EdgeCoil/tune-button/README.md

# Tune Button

A pocket remote for Spotify on Android. Out of the box its four keys **like** the song that's
playing, **add it to a playlist**, **skip**, and **play or pause**. Each key can also do something
else when held or double-pressed. It runs for months on a small battery and charges over USB-C.

It is **not a Bluetooth keyboard**, so nothing on the phone gets remapped. Each press sends a small,
signed Bluetooth broadcast. A companion app hears it in the background, even with the phone locked,
and does what you set that key to do.

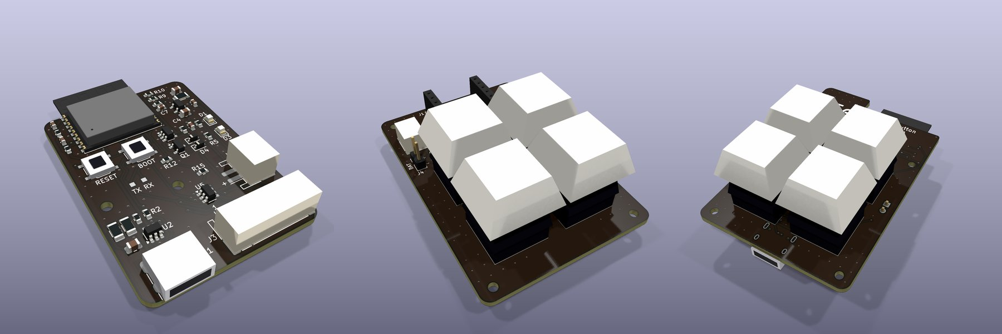
[picture p1: docs/renders/boards.jpg]
The three Tune Button boards

<sub>The three four-key boards (renders of rev A, which has arrived and is being brought up): `c3-jst` with buttons on a cable, the XIAO board, and the C3 board's key side.</sub>

```
 button ──wake──► ESP32-C3 ──signed BLE broadcast──► Android app ──HTTPS──► Spotify
                 (deep sleep)                      (listens in the         like, add, skip,
                                                    background)            play/pause, …
```

> **Status: works end to end.** A one-button unit on a XIAO ESP32-C3 liked the playing song from a
> locked Samsung phone; the app heard the press in 0.8 s. The four-key firmware and app (holds,
> double presses, playback control) are written and unit-tested; on the rev A boards the C3 board's
> four keys, sleep and wake work (2026-11-05), the XIAO board is flashed (without a cell so far), and the app hasn't been
> paired with a four-key board yet. Still to do: a longer latency run on each scan mode and a
> battery-life measurement. See [`docs/design.md`](docs/design.md).

## What you need

- **The button:** one of the four-key boards (see [Hardware](#hardware)), or a hand-wired Seeed
  Studio XIAO ESP32-C3 with a small LiPo cell and one or two 12 mm tactile switches
  ([`hardware/wiring.md`](hardware/wiring.md)). There are 3D-printable cases, and layered acrylic
  cases for the four-key boards ([`hardware/case`](hardware/case/README.md)).
- **An Android phone**, version 8.0 or later.
- **Spotify Premium.** Spotify requires it on the account that owns the developer app, and the
  developer app works for up to five users.

## Set up

### 1. Create a Spotify developer app

1. Sign in at [developer.spotify.com/dashboard](https://developer.spotify.com/dashboard) and create
   an app. Tick **Web API**.
2. Add the redirect URI **`tunebutton://callback`**.
3. Copy the **Client ID**. You don't need a client secret: the app signs in with PKCE.

### 2. Flash the firmware

Pick the build for your button:

| Button | Build (`-e`) | `sh scripts/merge.sh <build>` makes |
|---|---|---|
| Hand-wired XIAO, two buttons | `xiao_esp32c3` (the default) | `tune-button-c3.bin` |
| Hand-wired XIAO, one button | `xiao_esp32c3_1btn` | `tune-button-c3-1btn.bin` |
| XIAO four-key board | `xiao_board` | `tune-button-xiao-board.bin` |
| `c3` or `c3-jst` board | `c3_board` | `tune-button-c3-board.bin` |

With PlatformIO:

```bash
cd firmware
pio test -e native            # host tests: packet encoder, signatures and key gestures
pio run -e c3_board -t upload # build and flash over USB-C
```

Or make one image (table above) and flash it at offset `0x0`, either in Chrome with
[esptool-js](https://espressif.github.io/esptool-js/) or with
`esptool.py --chip esp32c3 write_flash 0 tune-button-c3.bin`.

**Only have one button?** Wire it to D1. A press acts when you let go; holding it for 5 seconds pairs.

Things worth knowing:
- **On a computer's USB it stays awake**, so the serial port stays up: `pio device monitor` shows a
  line per wake and per key sent, and `pio run -t upload` works as is. It notices within a few ms
  when the computer goes away, and sleeps. A plain USB charger sends no USB frames, so on one it
  sleeps as usual. Build with `-DTB_USB_HEARTBEAT` to also print the raw key state once a second.
- **Otherwise the USB port vanishes while the button sleeps**, which is almost all the time. To
  flash it, plug it into a computer and press a key (it stays up once the press is sent), or hold
  **BOOT** while plugging it in.
- **If it sits in `waiting for download` after an upload**, the reset after flashing kept it in
  the bootloader: unplug and replug it. `--after watchdog_reset` (esptool) avoids this.
- **Flashing the merged image at `0x0` erases the pairing**, so pair again afterwards.
  `pio run -t upload` keeps it.
- Build options in `platformio.ini`: `TB_BURST_MS` (how long each press is broadcast) and `TB_LED_PIN`.
- **Updating from the two-button firmware** keeps the pairing (with `pio run -t upload`), and the
  app still understands a button that hasn't been updated.

### 3. Install the app

```bash
cd android
./gradlew test assembleDebug      # needs JDK 17+ and Android SDK 35
```

Install `app/build/outputs/apk/debug/app-debug.apk` on the phone, open it and work down the screen:

1. Paste the Client ID and tap **Sign in to Spotify**. (Signed in before playback control existed?
   The app asks you to sign in again, to allow it.)
2. **Pair:** hold keys 1 and 2 (top left and top right) for 3 seconds (one-button build: hold it for
   5 seconds) until the LED flickers, then tap **Pair**. Accept the Bluetooth prompt if one appears.
   Pairing makes a fresh key, so a previously paired phone stops working; a pairing that no phone
   completes changes nothing.
3. **Keys:** tap any key's press, hold or double press to choose what it does. Key 2's press needs
   a playlist.
4. Fix everything listed under *Keep listening in the background*. **On Samsung phones, also add the
   app to *Never sleeping apps*,** or presses stop being heard after a few days.
5. Tap **Test without the device** to check the Spotify side on its own.

## Using it

Press a key. Within a moment the phone buzzes once and shows a notification, for example
"♥ Liked — Title · Artist" or "⏭ Next track". If something goes wrong it buzzes twice and says why:
nothing playing, signed out, a local file, and so on. Podcast episodes work too.

What a key can do, on press, hold (0.6 s) or double press:

| | |
|---|---|
| **The song** | like it, remove it from Liked Songs, add it to a playlist, remove it from a playlist |
| **Playback** | play / pause, next, previous, volume up or down 10 %, shuffle on / off, repeat (off → all → one), play a playlist |
| **Anything else** | call a webhook, such as a Home Assistant automation. It gets the key, the gesture and the song |

Each slot has its own playlist, so key 2 could add to one playlist and key 2 held to another.

**Holds and double presses cost a little speed, on that key only.** A key with nothing on hold or
double press sends the moment it goes down. One with a hold action waits for you to let go (or for
the hold); one with a double press waits 0.3 s for a second press. The button has to know which keys
wait, so after changing those, the app asks you to hold keys 1 and 2 for 3 seconds and tap **Send
key settings**. That doesn't re-pair anything.

Quick presses all count: three fast presses of skip are three skips.

The app's *Recent presses* list shows, for each press, how long the phone took to hear it, how long
Spotify took, the button's battery level and the result.

## Hardware

| Option | What it is | State |
|---|---|---|
| **Hand-wired XIAO** | A XIAO ESP32-C3 with one or two switches and a LiPo: [`hardware/wiring.md`](hardware/wiring.md) | One-button unit built and working |
| **3D-printed case** | Parametric OpenSCAD, with ready STLs: [`hardware/case/`](hardware/case/) | Ready to print |
| **Four-key PCBs** | Three boards: one carrying a XIAO, one with the ESP32-C3 module on board, and a small one that takes buttons on a cable. [`hardware/pcb/`](hardware/pcb/) | Rev A in bring-up; XIAO rev B designed |

The firmware supports all four boards. It runs on the rev A C3 board and is flashed on the rev A XIAO board (without a cell so far); `c3-jst` is untested.

## How it's put together

| Path | What it is |
|---|---|
| [`firmware/`](firmware/) | PlatformIO / Arduino firmware for the ESP32-C3 (NimBLE) |
| [`android/`](android/) | The companion app (Kotlin, Android 8+) |
| [`protocol/`](protocol/) | The broadcast format, and `gen_vectors.py`, which makes the test vectors both sides check against |
| [`hardware/`](hardware/) | Wiring, parts, the case and the PCBs |
| [`docs/design.md`](docs/design.md) | How it works, security, power budget, latency and bench tests |

Each press is signed with a key shared at pairing and carries a counter, so the app ignores copies
and anything not from your button. [`docs/design.md`](docs/design.md) has the details.

## Licence

| What | Licence |
|---|---|
| The case and PCBs: `hardware/case/`, `hardware/pcb/` (OpenSCAD and KiCad sources, STLs) | [CERN-OHL-S-2.0](LICENSES/CERN-OHL-S-2.0.txt) |
| Firmware, app, protocol tools | [MIT](LICENSES/MIT.txt) |
| The Gradle wrapper (`android/gradlew*`, `android/gradle/wrapper/`), as shipped by Gradle | [Apache-2.0](LICENSES/Apache-2.0.txt) |
| Documentation (`README.md`, `docs/` including the renders, `hardware/wiring.md`, `protocol/spec.md`) | [CC BY 4.0](LICENSES/CC-BY-4.0.txt) |
| The EdgeCoil mark (`hardware/pcb/edgecoil-mark.svg` and the silkscreen drawn from it), name and URL | [All rights reserved](LICENSES/LicenseRef-EdgeCoil-Mark.txt) |

Each source file carries an SPDX header, and [`REUSE.toml`](REUSE.toml) covers the rest by path.

The board licence does not cover the EdgeCoil mark, name or URL on the silkscreen. If you make or
sell boards from these designs, take them off.

Spotify is a trademark of Spotify AB. This project is not affiliated with or endorsed by Spotify.

---

edgecoil · [edgecoil.dev](https://edgecoil.dev)
