EdgeCoil/tune-button/hardware/case/stack/c3-jst/preview.png

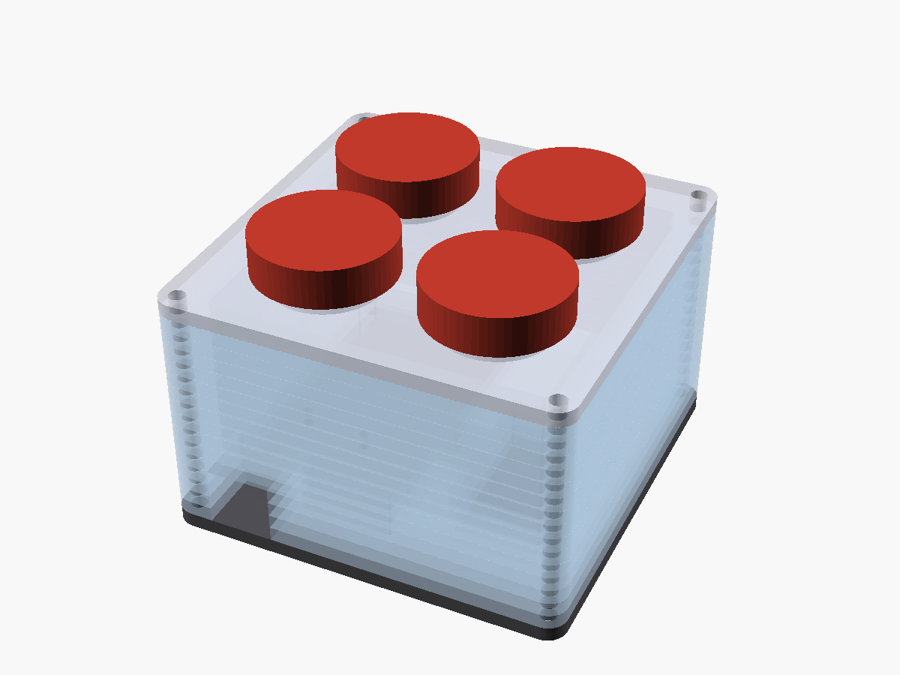
hardware/case/stack/c3-jst/preview.png
