EdgeCoil/tune-button/hardware/case/stack/c3-jst/wall.stl

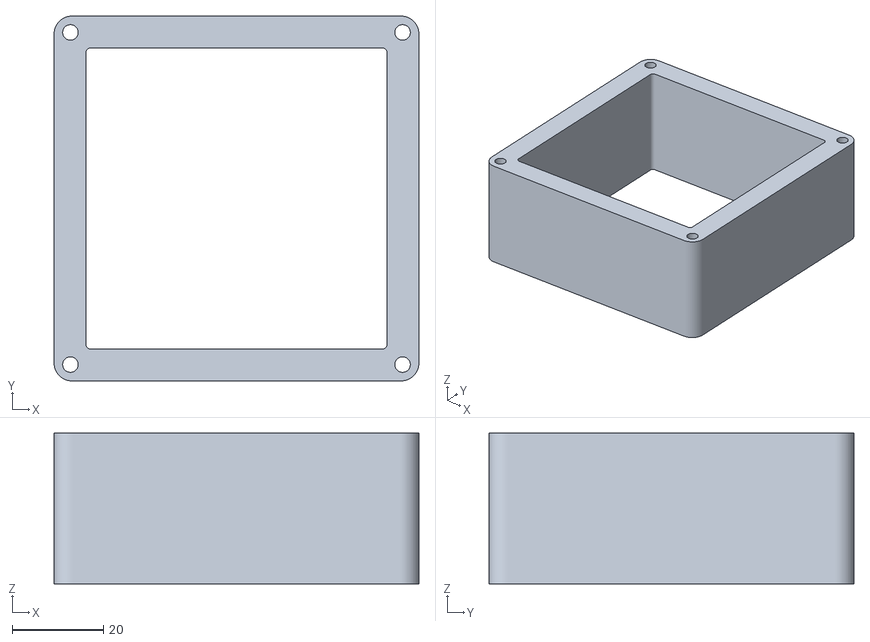
[picture p10: CAD file, 2026-11-04]
hardware/case/stack/c3-jst/wall.stl
80.0 x 80.0 x 33.0
