EdgeCoil/tune-button/hardware/case/stack/c3/sheet.dxf

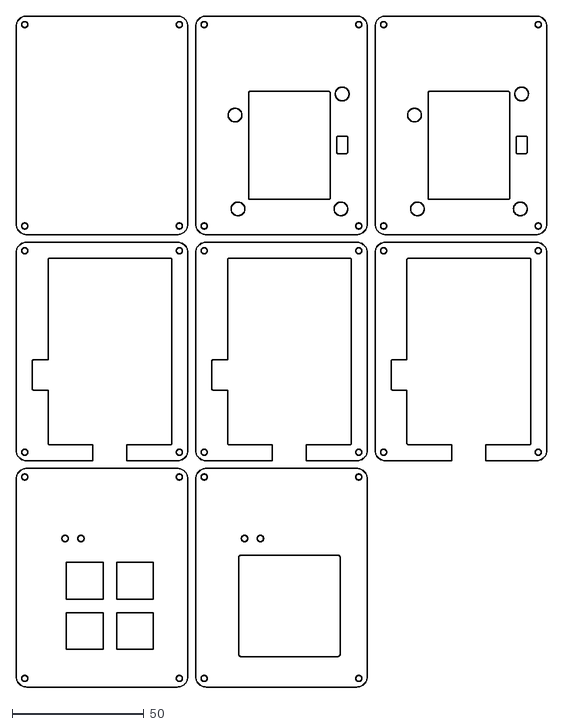
[picture p11: CAD file, 2026-11-04]
hardware/case/stack/c3/sheet.dxf
201.1 x 254.3
