EdgeCoil/tune-button/hardware/case/stack/xiao/spacers.stl

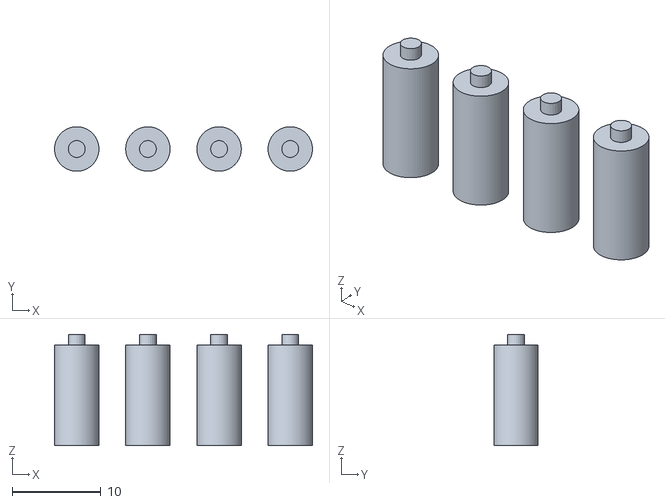
[picture p12: CAD file, 2026-11-04]
hardware/case/stack/xiao/spacers.stl
29.0 x 5.00 x 12.5
