EdgeCoil/tune-button/hardware/case/tune-button-c3-raven-tower.stl

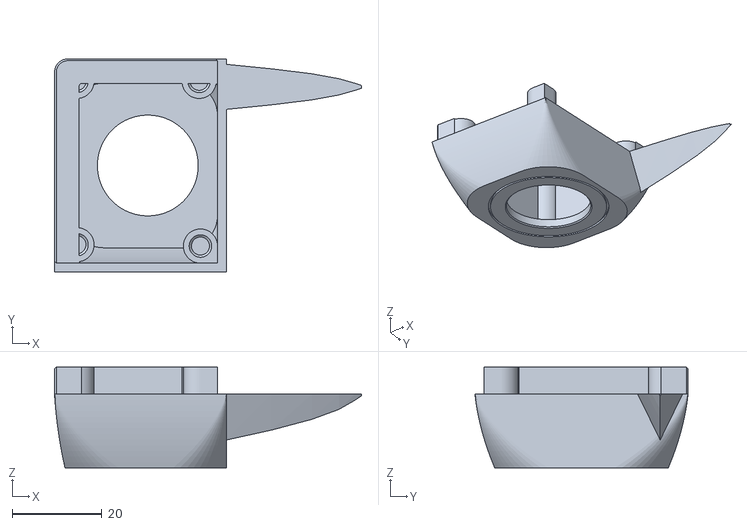
[picture p13: CAD file, 2026-11-13]
hardware/case/tune-button-c3-raven-tower.stl
68.3 x 47.4 x 22.4
