EdgeCoil/tune-button/hardware/case/stack/c3-jst/sheet.dxf

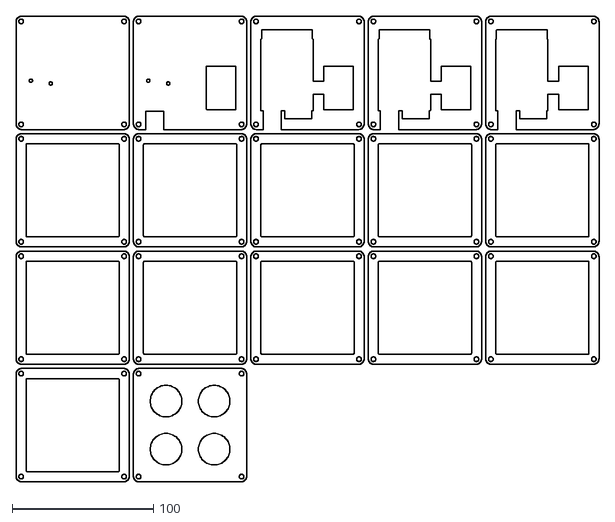
[picture p14: CAD file, 2026-11-04]
hardware/case/stack/c3-jst/sheet.dxf
412.1 x 329.1
