EdgeCoil/tune-button/hardware/case/stack/xiao/sheet.dxf

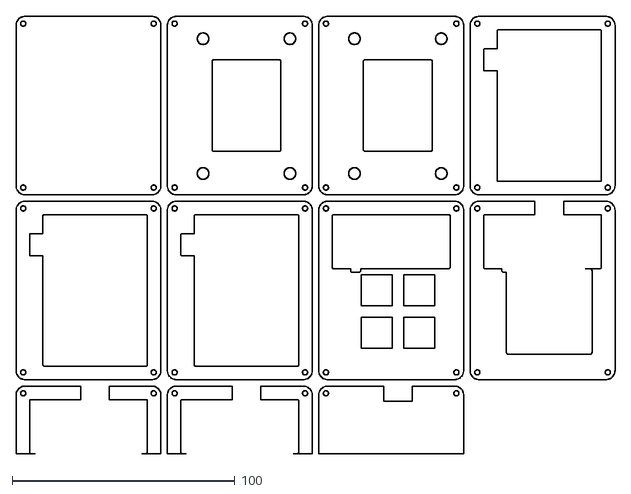
[picture p15: CAD file, 2026-11-04]
hardware/case/stack/xiao/sheet.dxf
269.1 x 196.5
