EdgeCoil/tune-button/hardware/case/tune-button-c3-raven-base.stl

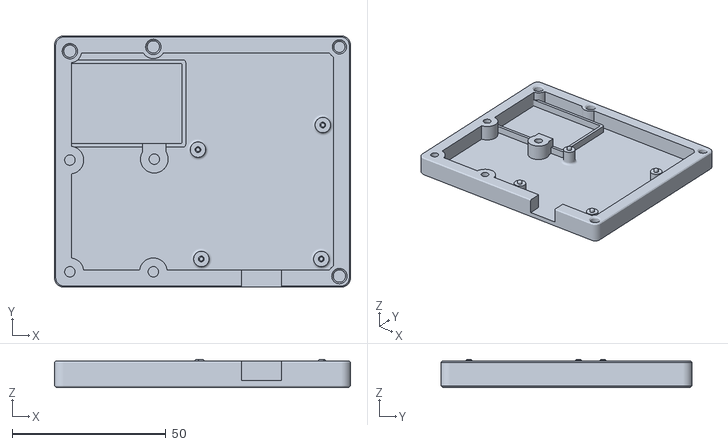
[picture p16: CAD file, 2026-11-13]
hardware/case/tune-button-c3-raven-base.stl
96.2 x 81.7 x 9.20
