EdgeCoil/tune-button/hardware/case/tune-button-c3-btn-tower.stl

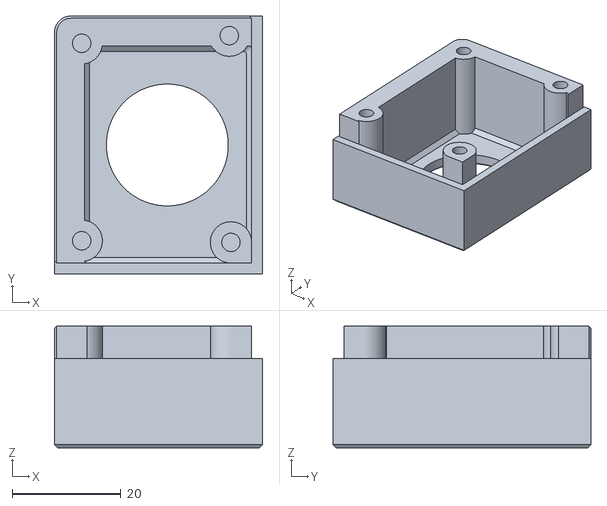
[picture p17: CAD file, 2026-11-09]
hardware/case/tune-button-c3-btn-tower.stl
38.2 x 47.4 x 22.4
