EdgeCoil/tune-button/hardware/case/tune-button-c3-btn-lid.stl

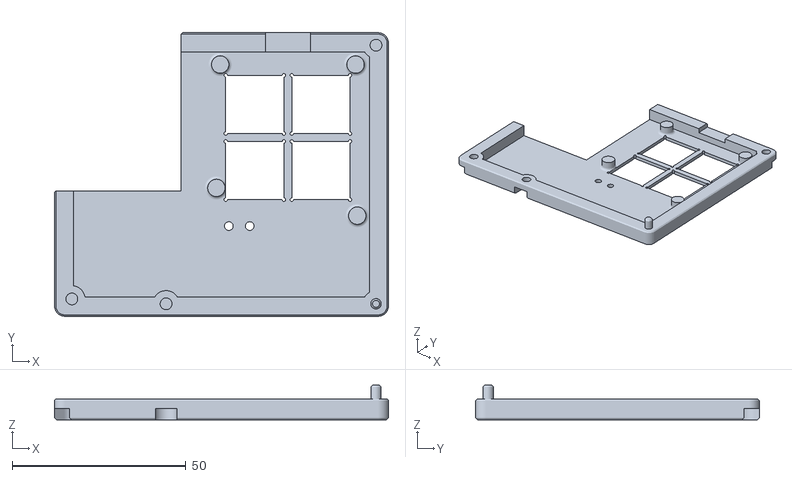
[picture p18: CAD file, 2026-11-09]
hardware/case/tune-button-c3-btn-lid.stl
96.2 x 81.7 x 10.00
