EdgeCoil/tune-button/hardware/case/tune-button-c3-lid.stl

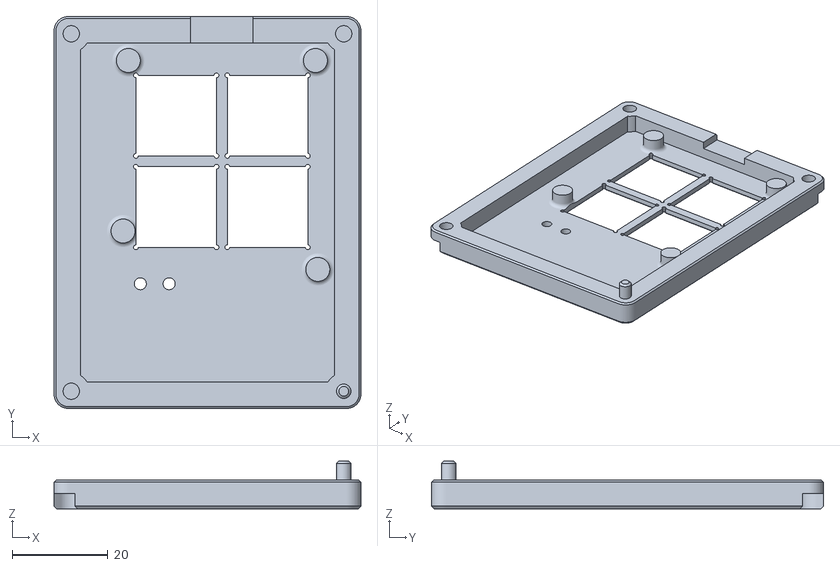
[picture p19: CAD file, 2026-11-05]
hardware/case/tune-button-c3-lid.stl
64.0 x 81.7 x 10.00
