EdgeCoil/tune-button/hardware/case/tune-button-xiao-lid.stl

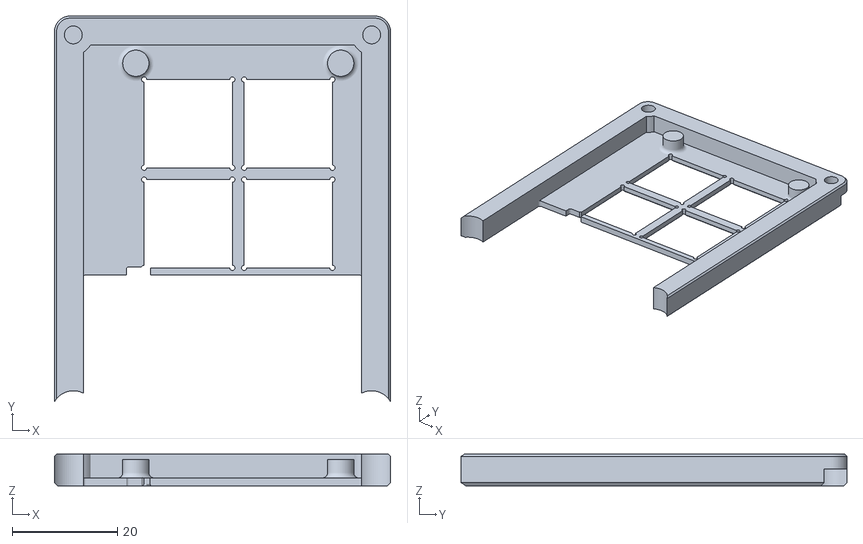
[picture p20: CAD file, 2026-11-05]
hardware/case/tune-button-xiao-lid.stl
64.0 x 73.5 x 6.00
