EdgeCoil/tune-button/hardware/case/tune-button-mx-gauge.stl

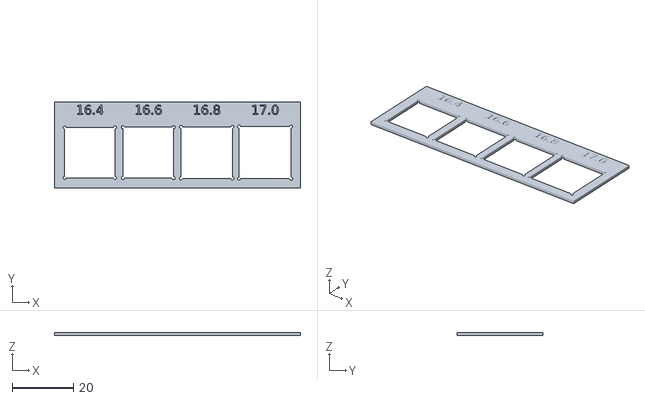
[picture p21: CAD file, 2026-11-05]
hardware/case/tune-button-mx-gauge.stl
80.2 x 28.1 x 1.00
