EdgeCoil/tune-button/hardware/case/tune-button-xiao-hood.stl

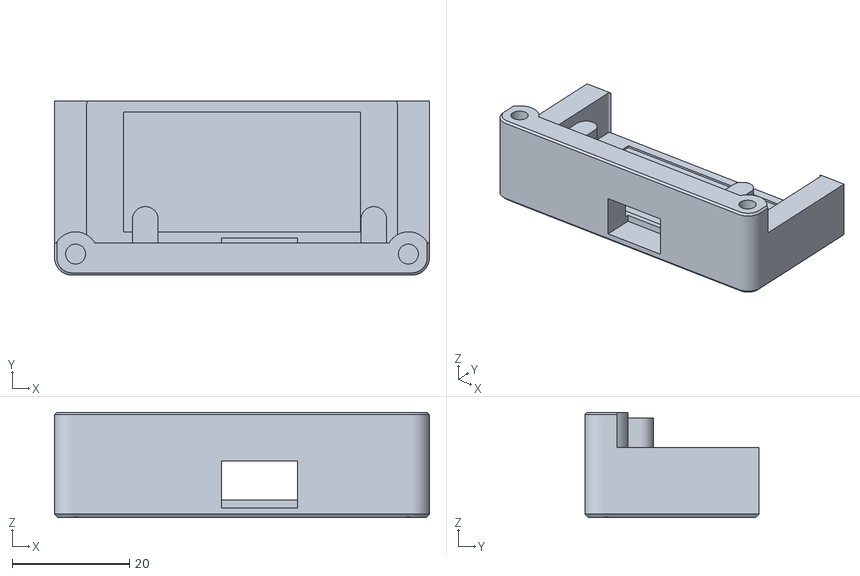
[picture p22: CAD file, 2026-11-04]
hardware/case/tune-button-xiao-hood.stl
64.0 x 29.8 x 18.0
