EdgeCoil/tune-button/hardware/case/tune-button-xiao-base.stl

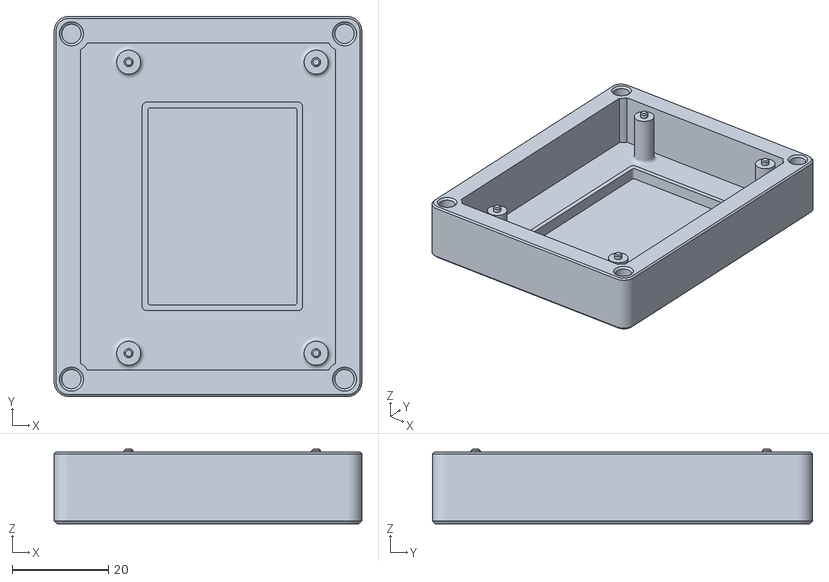
[picture p23: CAD file, 2026-11-04]
hardware/case/tune-button-xiao-base.stl
64.0 x 79.0 x 15.6
