EdgeCoil/tune-button/hardware/case/tune-button-c3-base.stl

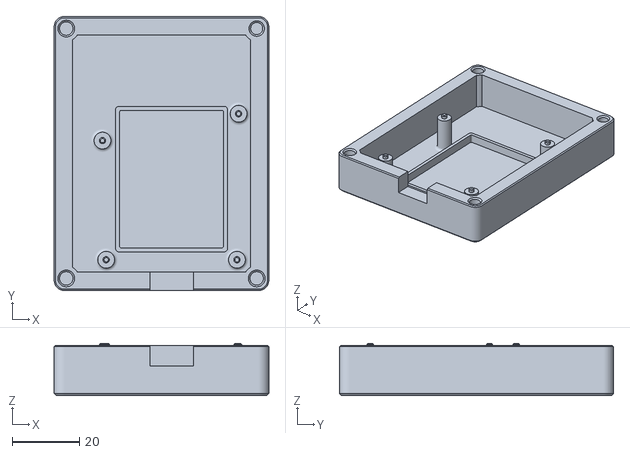
[picture p24: CAD file, 2026-11-04]
hardware/case/tune-button-c3-base.stl
64.0 x 81.7 x 15.6
