EdgeCoil/tune-button/hardware/case/tune-button-1btn-base.stl

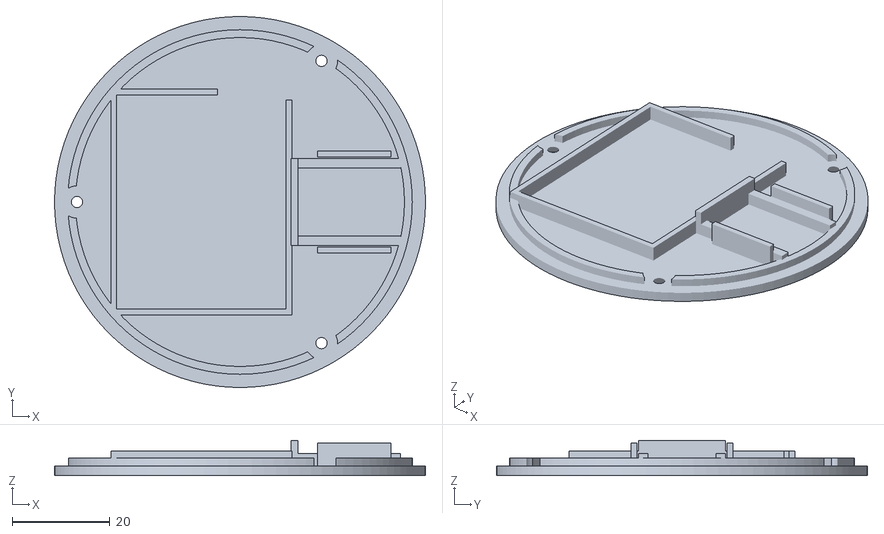
[picture p25: CAD file, 2026-10-21]
hardware/case/tune-button-1btn-base.stl
75.8 x 75.8 x 7.20
