EdgeCoil/tune-button/hardware/case/tune-button-1btn-body.stl

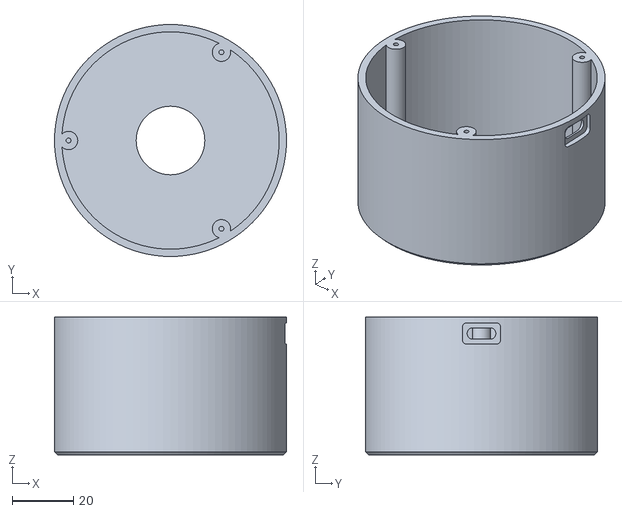
[picture p26: CAD file, 2026-10-21]
hardware/case/tune-button-1btn-body.stl
75.8 x 75.8 x 45.0
