EdgeCoil/tune-button/hardware/case/tune-button-lid.stl

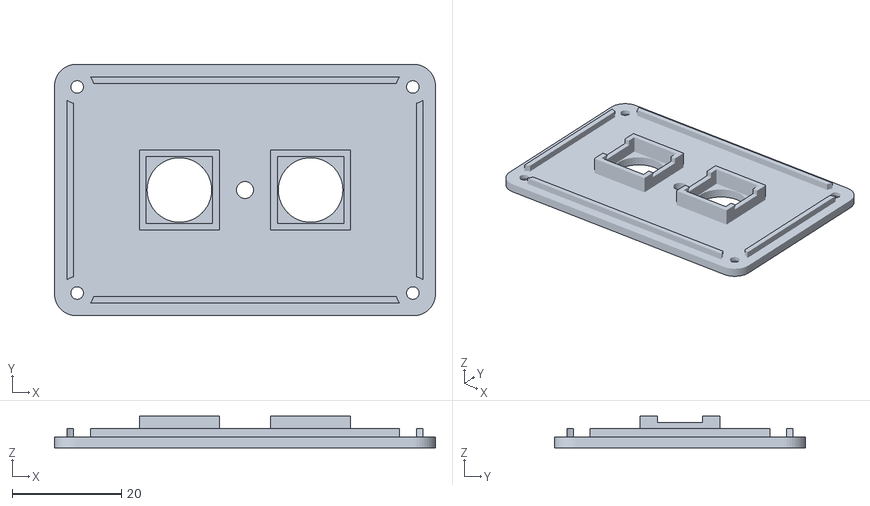
[picture p27: CAD file, 2026-10-19]
hardware/case/tune-button-lid.stl
69.7 x 46.0 x 5.80
