EdgeCoil/tune-button/hardware/case/tune-button-base.stl

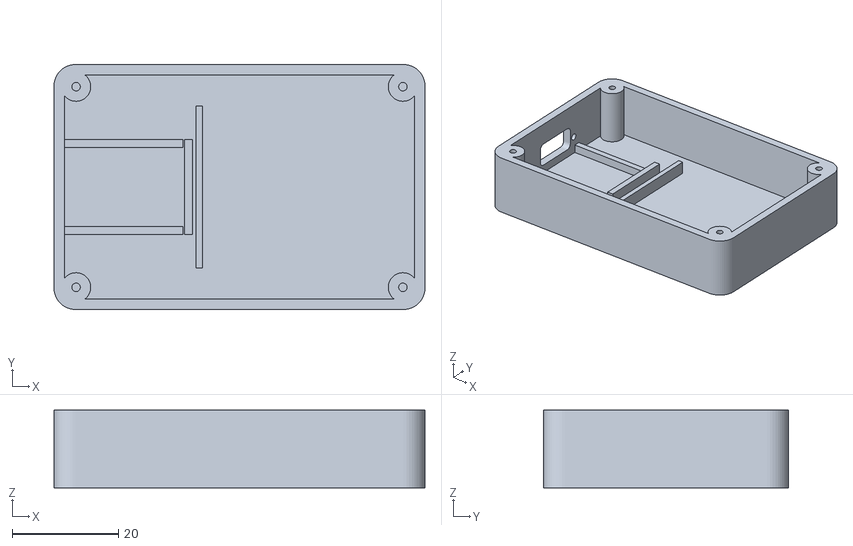
[picture p28: CAD file, 2026-10-19]
hardware/case/tune-button-base.stl
69.7 x 46.0 x 14.6
