EdgeCoil/tune-button/hardware/case/tune-button-mx-gauge.scad

// SPDX-FileCopyrightText: 2026 edgecoil
// SPDX-License-Identifier: CERN-OHL-S-2.0
//
// MX hole gauge: four switch holes cut the same way as the printed lid's plate (1.5 mm, corner
// reliefs, the chamfer on the bed face). Print it with the same filament and settings as the lid.
//   mx_fit "over" (the default): push a soldered switch's top up through each hole from below and
//     pick the smallest it passes cleanly, flange and all.
//   mx_fit "clip": press a switch in from above and pick the smallest it goes fully into, clips
//     latched. Build with -D 'mx_fit="clip"'.
// Then set pmx_hole in tune-button-printed.scad.
//
//   openscad -o tune-button-mx-gauge.stl tune-button-mx-gauge.scad
include <tune-button-printed.scad>
piece = "none";

sizes = mx_fit == "over" ? [16.4, 16.6, 16.8, 17.0] : [14.0, 14.1, 14.2, 14.3];
labels = [for (x = sizes) let(s = str(x)) len(s) == 2 ? str(s, ".0") : s];
pitch = 19.05;
t = plate_t;
w = len(sizes) * pitch + 4;
d = pitch + 9;
assert(sizes[len(sizes) - 1] + 1 < pitch, "holes too big for the pitch");

// Built upright (top face at z = t), then turned over: the top face prints on the bed, as on the lid.
translate([0, 0, t]) rotate([180, 0, 0]) difference() {
    translate([-w / 2, -d / 2, 0]) cube([w, d, t]);
    for (i = [0 : len(sizes) - 1]) translate([(i - (len(sizes) - 1) / 2) * pitch, 2.5, 0]) mx_cut(t, sizes[i]);
    // each size engraved under its hole, on the underside (the side facing up as printed)
    for (i = [0 : len(sizes) - 1]) translate([(i - (len(sizes) - 1) / 2) * pitch, -d / 2 + 2.6, -0.01])
        mirror([0, 1, 0]) linear_extrude(height = 0.6) text(labels[i], size = 3, halign = "center", valign = "center");
}
