EdgeCoil/tune-button/(list of files, cad)

Other CAD files:
hardware/case/stack/c3/spacers.stl
hardware/case/tune-button-c3-btn-base.stl
