EdgeCoil/tune-button/hardware/case/stack/c3/printed-preview.png

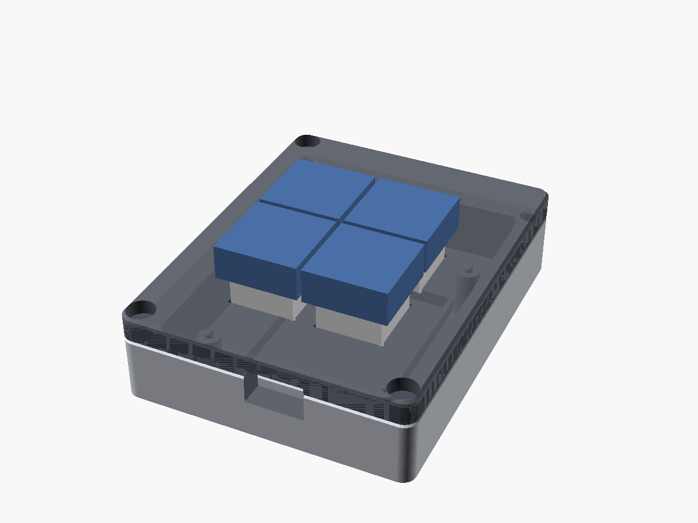
hardware/case/stack/c3/printed-preview.png
