EdgeCoil/tune-button/hardware/pcb/xiao/tune-button-xiao.kicad_pcb

## KiCad design hardware/pcb/xiao/tune-button-xiao.kicad_pcb (2026-11-05)

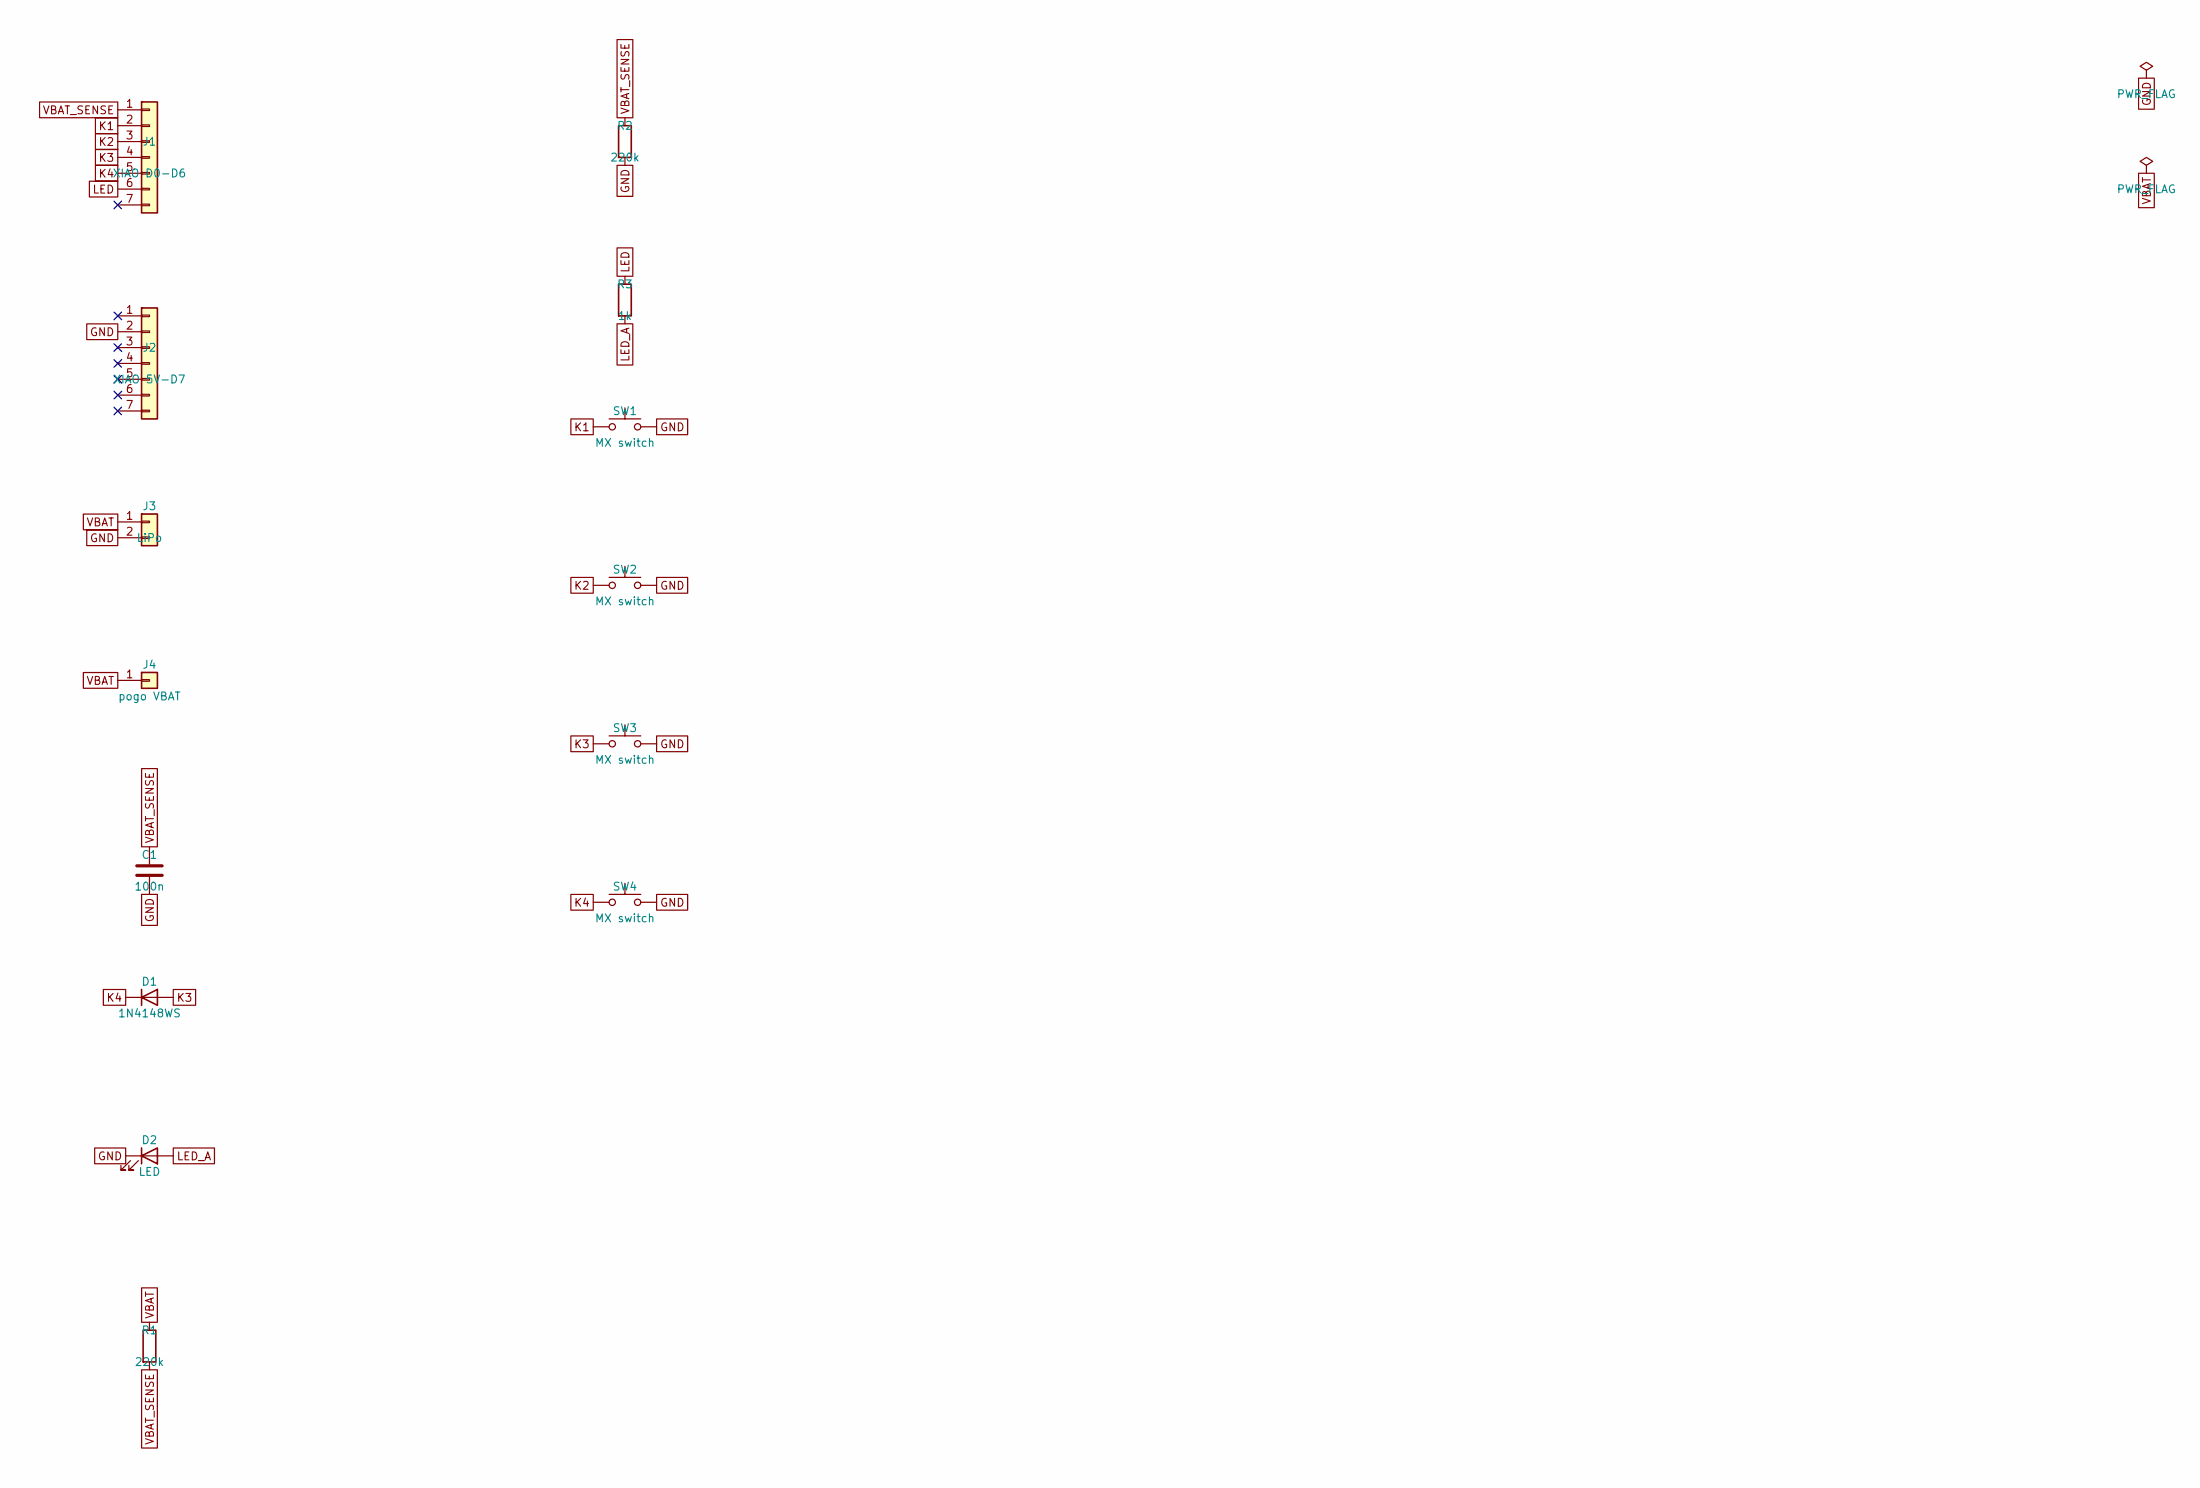
[picture p30: schematic tune-button-xiao.kicad_sch, tune-button xiao]

Parts:
C1: 100n; C_0603_1608Metric; LCSC C14663
D1: 1N4148WS; D_SOD-323_HandSoldering; MPN 1N4148WS; LCSC C2128
D2: LED; LED_0603_1608Metric; LCSC C2286
J1: XIAO D0-D6; PinSocket_1x07_P2.54mm_Vertical; MPN Kinghelm KH-2.54FH-1X7P-H8.5; LCSC C2932672
J2: XIAO 5V-D7; PinSocket_1x07_P2.54mm_Vertical; MPN Kinghelm KH-2.54FH-1X7P-H8.5; LCSC C2932672
J3: LiPo; JST_PH_S2B-PH-SM4-TB_1x02-1MP_P2.00mm_Horizontal; MPN JST S2B-PH-SM4-TB; LCSC C295747
J4: pogo VBAT; PogoPin_YTC1P_D2.0_SMD; MPN YIYUAN YTC1P-8535-01; LCSC C5221289
R1, R2: 220k; R_0603_1608Metric; LCSC C22961
R3: 1k; R_0603_1608Metric; LCSC C21190
SW1, SW2, SW3, SW4: MX switch; SW_Cherry_MX_1.00u_PCB_Reversible; MPN Cherry MX (3 or 5 pin)

Connections:
GND: C1.2, D2.1 (K), J2.2, J3.2, R2.2, SW1.2, SW2.2, SW3.2, SW4.2
K1: J1.2, SW1.1
K2: J1.3, SW2.1
K3: D1.2 (A), J1.4, SW3.1
K4: D1.1 (K), J1.5, SW4.1
LED: J1.6, R3.1
LED_A: D2.2 (A), R3.2
VBAT: J3.1, J4.1, R1.1
VBAT_SENSE: C1.1, J1.1, R1.2, R2.1

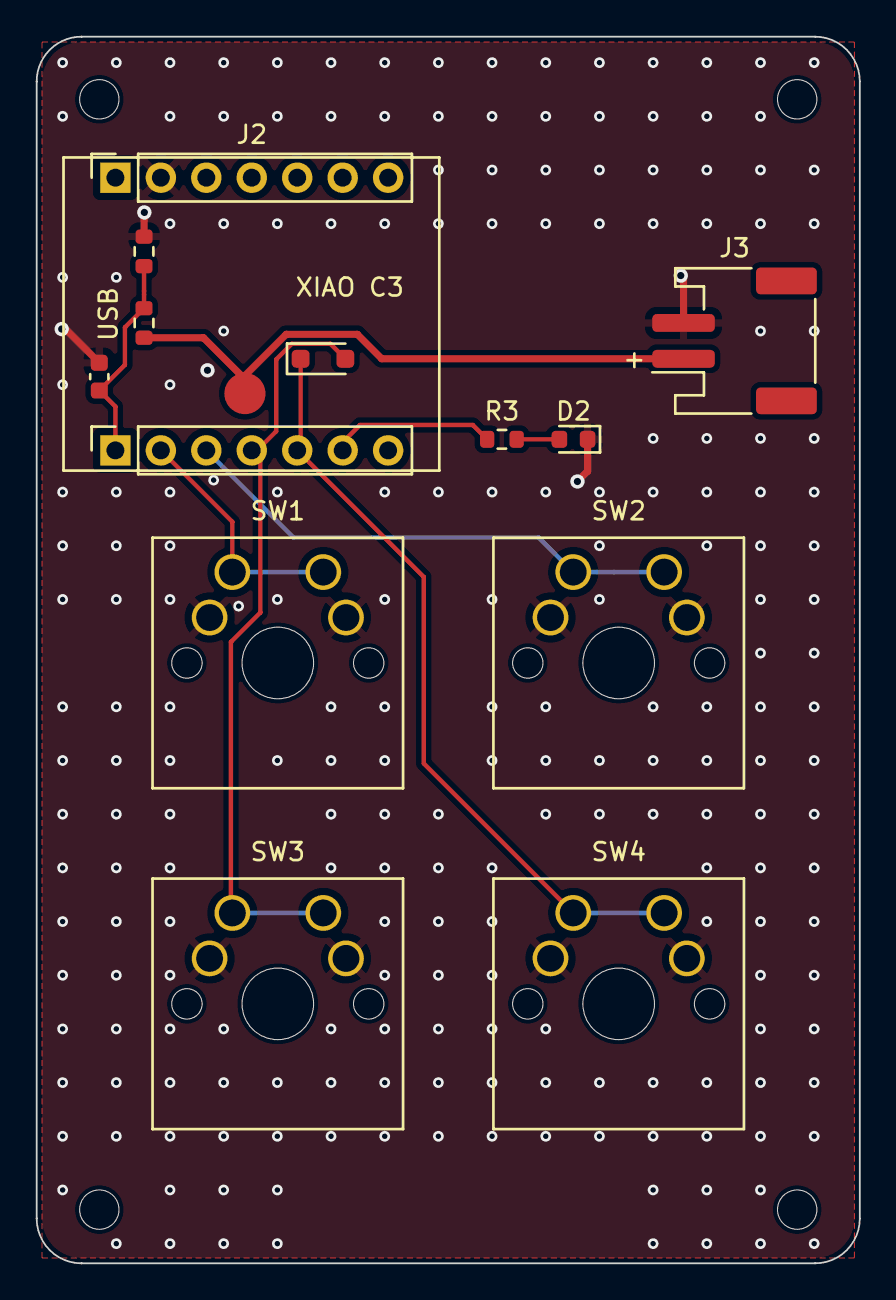
[picture p31: board tune-button-xiao.kicad_pcb from above]

Board: 2 copper layers, 46.0 x 68.5 mm, 18 parts (0 on the bottom side), 9 nets.

Other parts of the board:
H1, H2, H3, H4: M2; MountingHole_2.2mm_M2
