EdgeCoil/tune-button/hardware/pcb/c3/tune-button-c3.kicad_pcb

## KiCad design hardware/pcb/c3/tune-button-c3.kicad_pcb (2026-10-25)

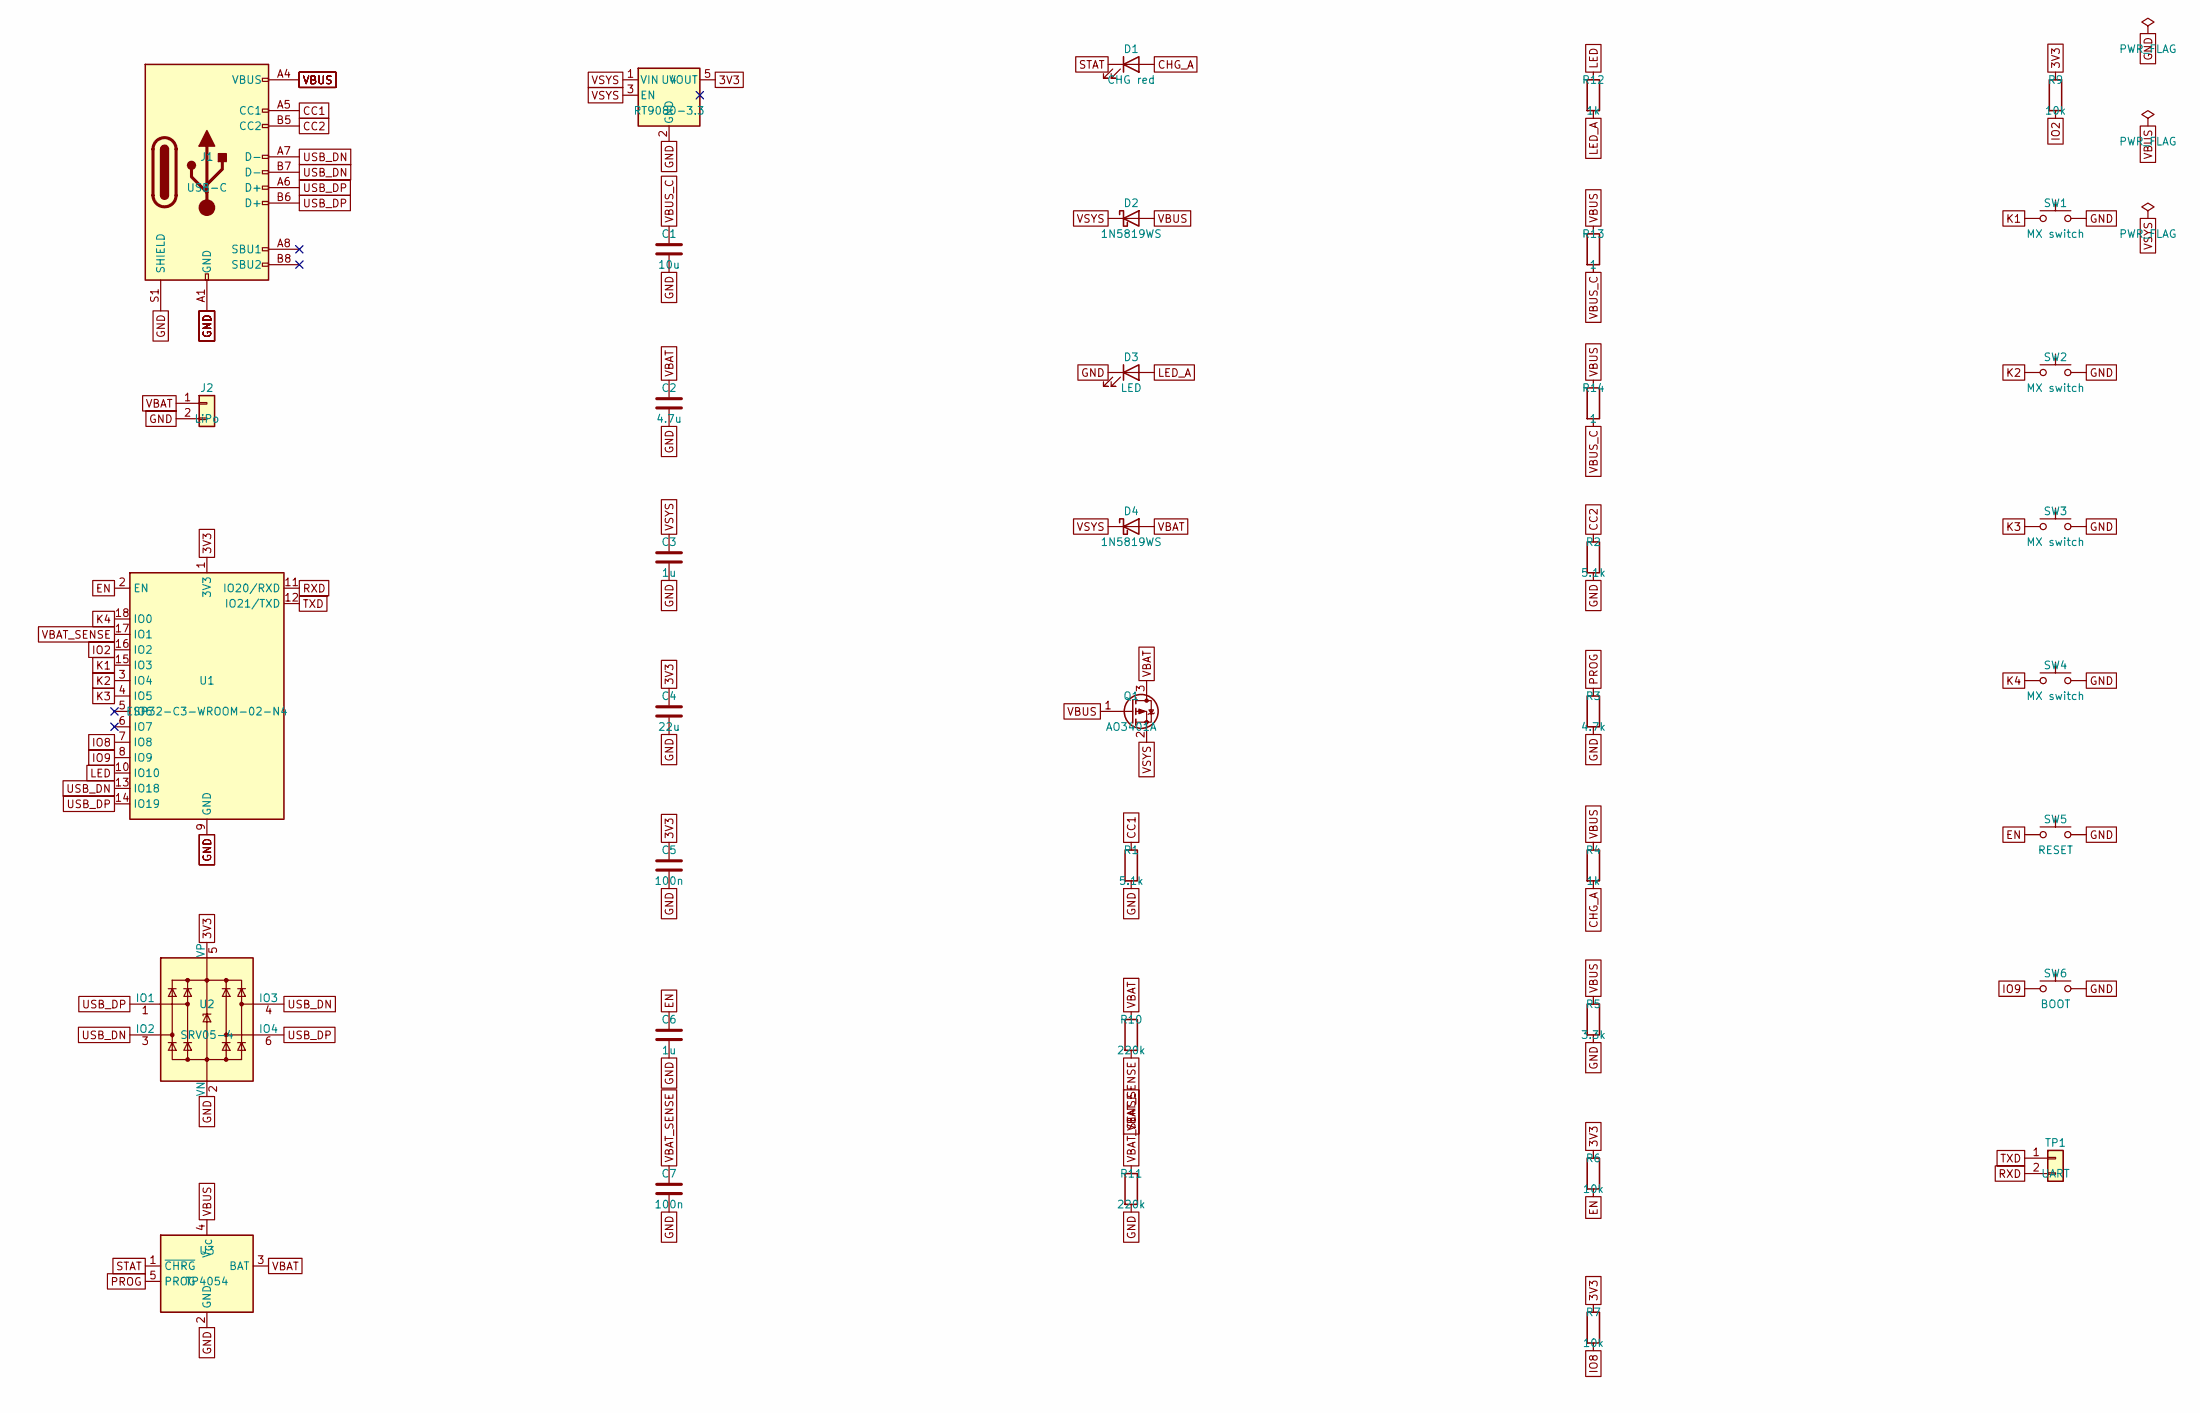
[picture p32: schematic tune-button-c3.kicad_sch, tune-button c3]

Parts:
C1: 10u; C_0805_2012Metric; LCSC C15850
C2: 4.7u; C_0603_1608Metric; LCSC C19666
C3, C6: 1u; C_0603_1608Metric; LCSC C15849
C4: 22u; C_0805_2012Metric; LCSC C45783
C5, C7: 100n; C_0603_1608Metric; LCSC C14663
D1: CHG red; LED_0805_2012Metric
D2, D4: 1N5819WS; D_SOD-323; MPN 1N5819WS; LCSC C191023
D3: LED; LED_0805_2012Metric
J1: USB-C; USB_C_Receptacle_HRO_TYPE-C-31-M-12; MPN HRO TYPE-C-31-M-12; LCSC C165948
J2: LiPo; JST_PH_S2B-PH-SM4-TB_1x02-1MP_P2.00mm_Horizontal; MPN JST S2B-PH-SM4-TB; LCSC C295747
Q1: AO3401A; SOT-23; MPN AO3401A; LCSC C15127
R1, R2: 5.1k; R_0603_1608Metric; LCSC C23186
R3: 4.7k; R_0603_1608Metric; LCSC C23162
R4, R12: 1k; R_0603_1608Metric; LCSC C21190
R5: 3.3k; R_0603_1608Metric; LCSC C22978
R6, R7, R9: 10k; R_0603_1608Metric; LCSC C25804
R10, R11: 220k; R_0603_1608Metric; LCSC C22961
R13, R14: 1; R_1206_3216Metric; LCSC C17928
SW1, SW2, SW3, SW4: MX switch; SW_Cherry_MX_1.00u_PCB; MPN Cherry MX (3 or 5 pin)
SW5: RESET; SW_Push_1P1T_XKB_TS-1187A; MPN XKB TS-1187A-B-A-B; LCSC C318884
SW6: BOOT; SW_Push_1P1T_XKB_TS-1187A; MPN XKB TS-1187A-B-A-B; LCSC C318884
TP1: UART; PinHeader_1x02_P2.54mm_Vertical
U1: ESP32-C3-WROOM-02-N4; ESP32-C3-WROOM-02; MPN ESP32-C3-WROOM-02-N4; LCSC C2934560
U2: SRV05-4; SOT-23-6; MPN SRV05-4-P-T7; LCSC C85364
U3: TP4054; SOT-23-5; MPN TP4054-42-SOT25R; LCSC C32574
U4: RT9080-3.3; SOT-23-5; MPN RT9080-33GJ5; LCSC C841192

Connections:
3V3: C4.1, C5.1, R6.1, R7.1, R9.1, U1.1 (3V3), U2.5 (VP), U4.5 (VOUT)
CC1: J1.A5 (CC1), R1.1
CC2: J1.B5 (CC2), R2.1
CHG_A: D1.2 (A), R4.2
EN: C6.1, R6.2, SW5.1, U1.2 (EN)
GND: C1.2, C2.2, C3.2, C4.2, C5.2, C6.2, C7.2, D3.1 (K), J1.A1 (GND), J1.A12 (GND), J1.B1 (GND), J1.B12 (GND), J1.S1 (SHIELD), J2.2, R1.2, R2.2, R3.2, R5.2, R11.2, SW1.2, SW2.2, SW3.2, SW4.2, SW5.2, SW6.2, U1.9 (GND), U1.19 (GND), U2.2 (VN), U3.2 (GND), U4.2 (GND)
IO2: R9.2, U1.16 (IO2)
IO8: R7.2, U1.7 (IO8)
IO9: SW6.1, U1.8 (IO9)
K1: SW1.1, U1.15 (IO3)
K2: SW2.1, U1.3 (IO4)
K3: SW3.1, U1.4 (IO5)
K4: SW4.1, U1.18 (IO0)
LED: R12.1, U1.10 (IO10)
LED_A: D3.2 (A), R12.2
PROG: R3.1, U3.5 (PROG)
RXD: TP1.2, U1.11 (IO20/RXD)
STAT: D1.1 (K), U3.1 (~CHRG)
TXD: TP1.1, U1.12 (IO21/TXD)
USB_DN: J1.A7 (D-), J1.B7 (D-), U1.13 (IO18), U2.3 (IO2), U2.4 (IO3)
USB_DP: J1.A6 (D+), J1.B6 (D+), U1.14 (IO19), U2.1 (IO1), U2.6 (IO4)
VBAT: C2.1, D4.2 (A), J2.1, Q1.3 (D), R10.1, U3.3 (BAT)
VBAT_SENSE: C7.1, R10.2, R11.1, U1.17 (IO1)
VBUS: D2.2 (A), J1.A4 (VBUS), J1.A9 (VBUS), J1.B4 (VBUS), J1.B9 (VBUS), Q1.1 (G), R4.1, R5.1, R13.1, R14.1, U3.4 (V_{CC})
VBUS_C: C1.1, R13.2, R14.2
VSYS: C3.1, D2.1 (K), D4.1 (K), Q1.2 (S), U4.1 (VIN), U4.3 (EN)

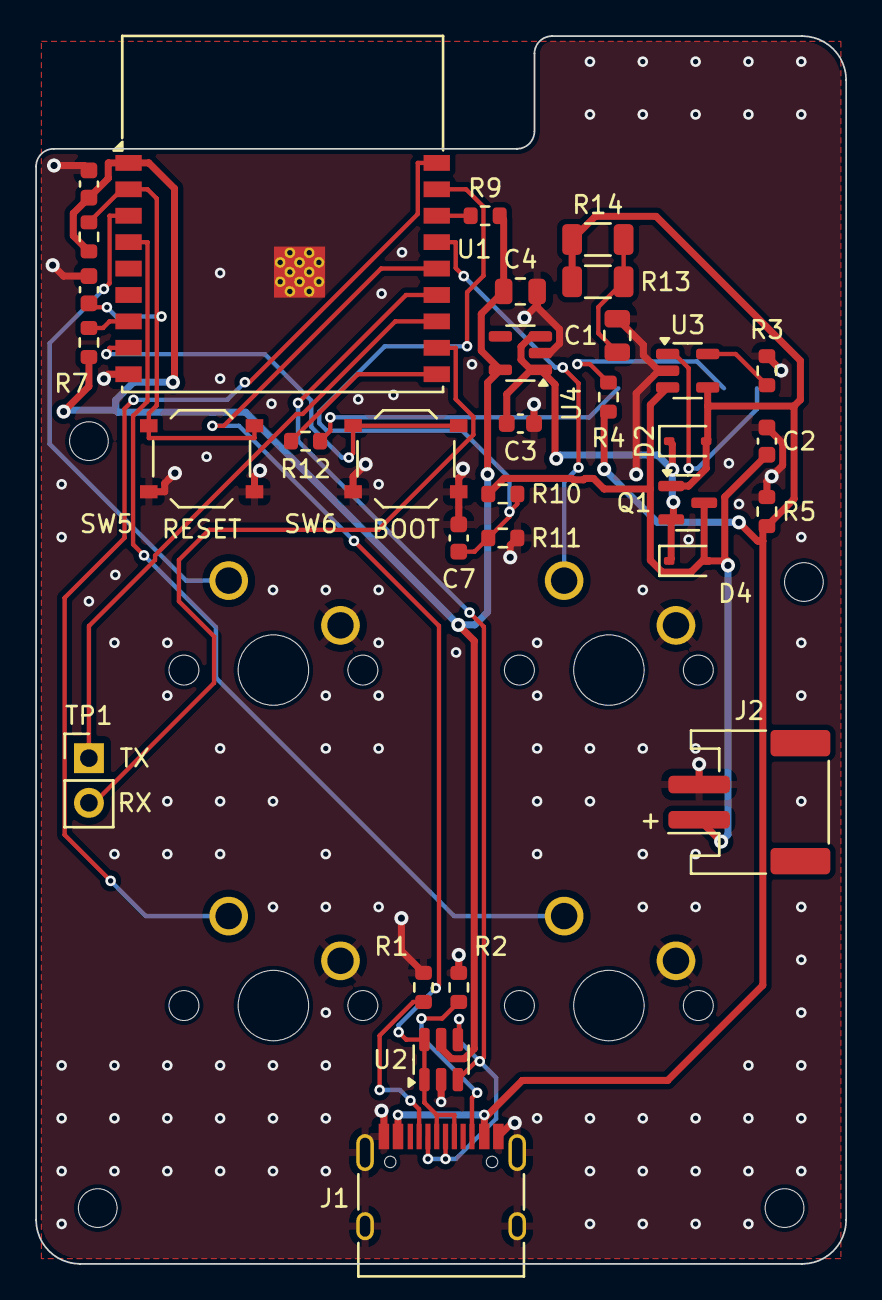
[picture p33: board tune-button-c3.kicad_pcb from above]

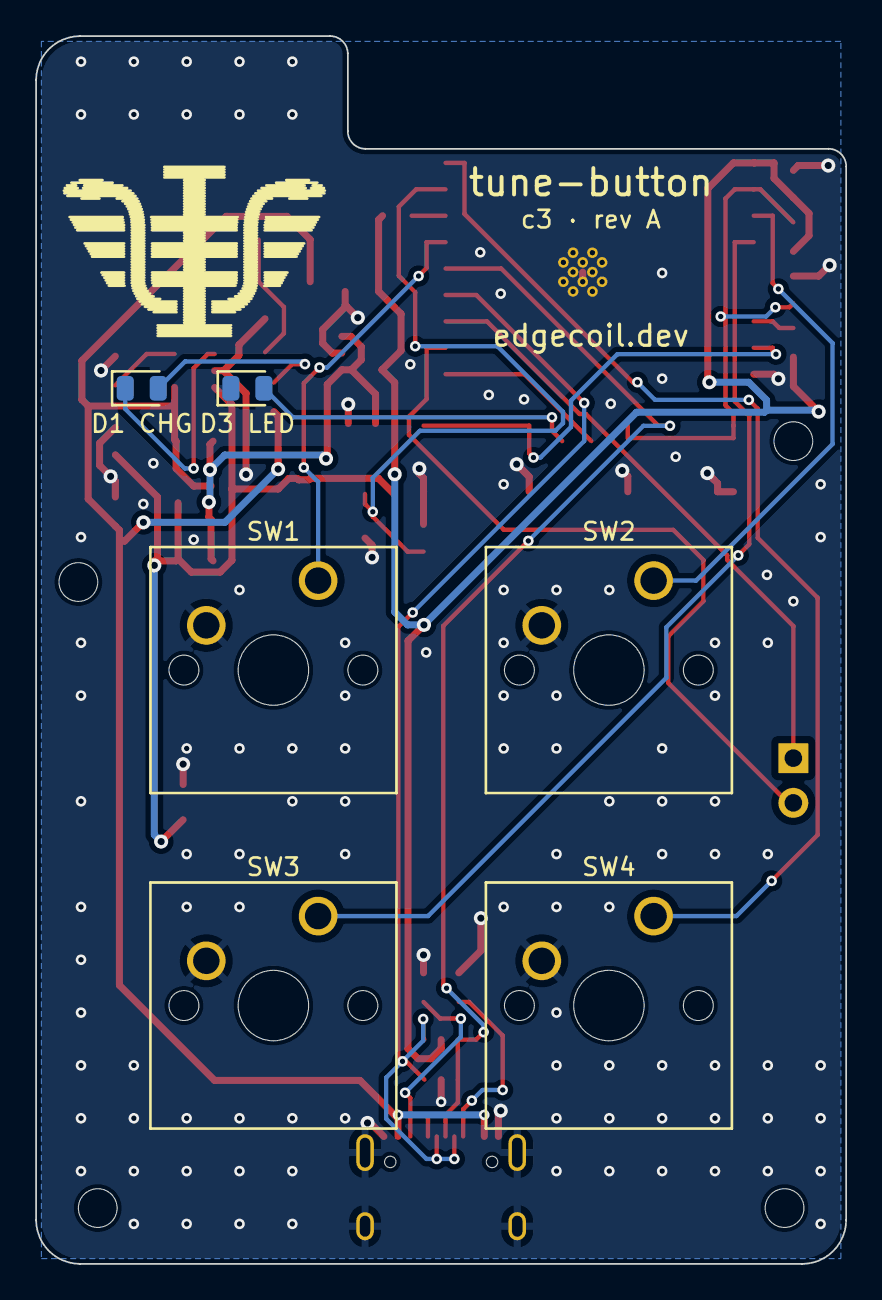
[picture p34: board tune-button-c3.kicad_pcb from below]

Board: 2 copper layers, 46.0 x 69.7 mm, 42 parts (6 on the bottom side), 26 nets.

Other parts of the board:
H1, H2, H3, H4: M2; MountingHole_2.2mm_M2
