EdgeCoil/tune-button/hardware/pcb/panel/tune-button-panel.kicad_pcb

## KiCad design hardware/pcb/panel/tune-button-panel.kicad_pcb (2026-11-05)

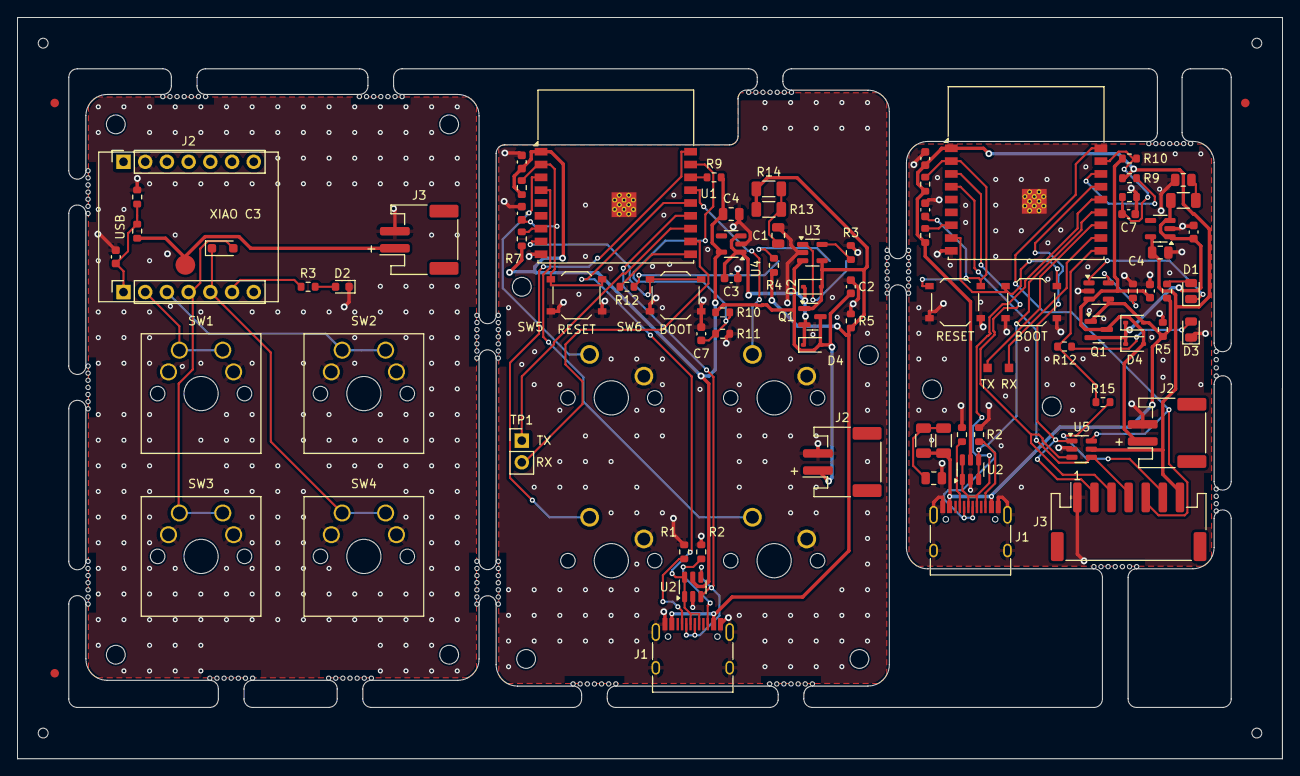
[picture p35: board tune-button-panel.kicad_pcb from above]

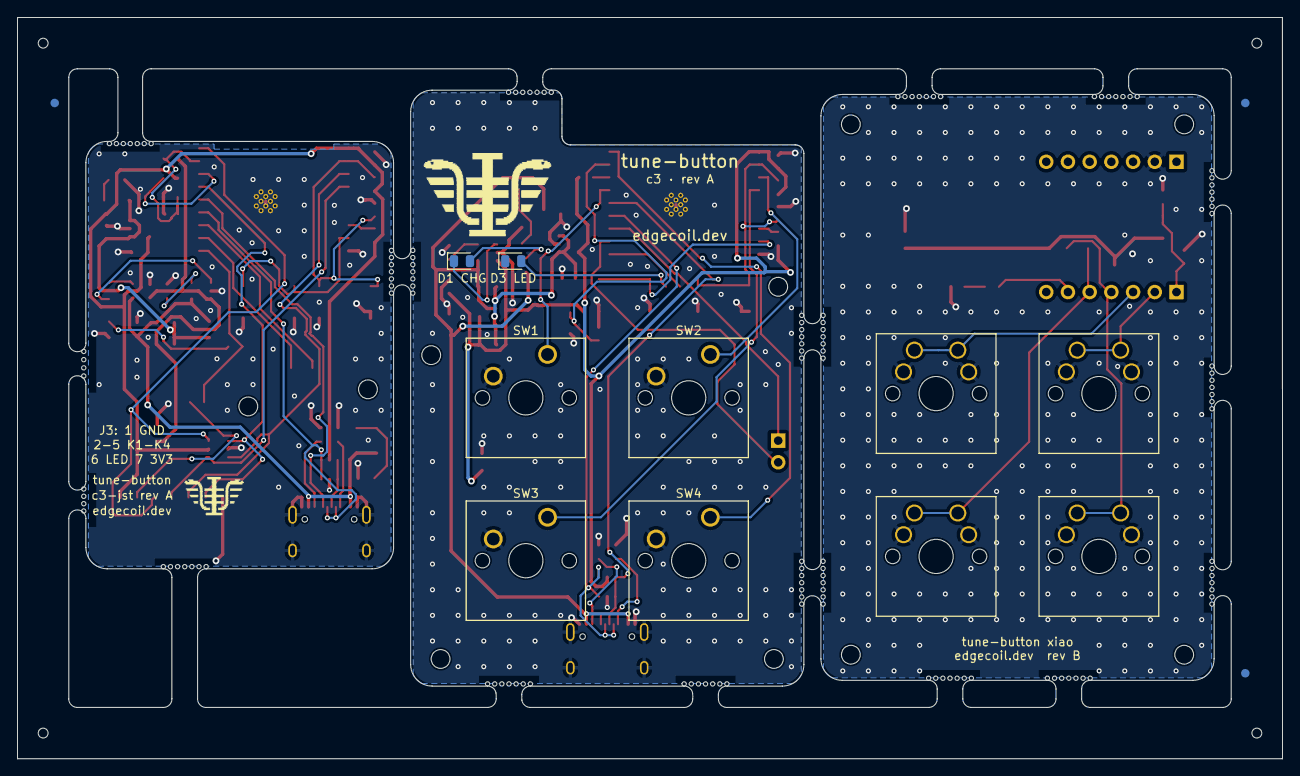
[picture p36: board tune-button-panel.kicad_pcb from below]

Board: 2 copper layers, 148.0 x 86.7 mm, 246 parts (9 on the bottom side), 63 nets.

Parts:
C1, C5, C5#2, C7, C7#2: 100n; C_0603_1608Metric
C1#2, C1#3, C8: 10u; C_0805_2012Metric
C2, C2#2: 4.7u; C_0603_1608Metric
C3, C3#2, C6, C6#2: 1u; C_0603_1608Metric
C4, C4#2: 22u; C_0805_2012Metric
D1: 1N4148WS; D_SOD-323_HandSoldering
D1#2, D1#3: CHG red; LED_0805_2012Metric
D2, D2#2, D4, D4#2: 1N5819WS; D_SOD-323
D2#3: LED; LED_0603_1608Metric
D3, D3#2: LED; LED_0805_2012Metric
H1, H1#2, H1#3, H2, H2#2, H2#3, H3, H3#2, H4, H4#2: M2; MountingHole_2.2mm_M2
J1: XIAO D0-D6; PinSocket_1x07_P2.54mm_Vertical
J1#2, J1#3: USB-C; USB_C_Receptacle_HRO_TYPE-C-31-M-12
J2, J2#2, J3: LiPo; JST_PH_S2B-PH-SM4-TB_1x02-1MP_P2.00mm_Horizontal
J2#3: XIAO 5V-D7; PinSocket_1x07_P2.54mm_Vertical
J3#2: Buttons; JST_PH_S7B-PH-SM4-TB_1x07-1MP_P2.00mm_Horizontal
J4: pogo VBAT; PogoPin_YTC1P_D2.0_SMD
KiKit_FID_B_1, KiKit_FID_B_2, KiKit_FID_B_3: Fiducial
KiKit_FID_T_1, KiKit_FID_T_2, KiKit_FID_T_3: Fiducial
KiKit_MB_1_1, KiKit_MB_1_2, KiKit_MB_1_3, KiKit_MB_1_4, KiKit_MB_1_5, KiKit_MB_1_6, KiKit_MB_1_7, KiKit_MB_2_1, KiKit_MB_2_2, KiKit_MB_2_3, KiKit_MB_2_4, KiKit_MB_2_5, KiKit_MB_2_6, KiKit_MB_2_7, KiKit_MB_3_1, KiKit_MB_3_2, KiKit_MB_3_3, KiKit_MB_3_4, KiKit_MB_3_5, KiKit_MB_3_6, KiKit_MB_3_7, KiKit_MB_4_1, KiKit_MB_4_2, KiKit_MB_4_3, KiKit_MB_4_4, KiKit_MB_4_5, KiKit_MB_4_6, KiKit_MB_4_7, KiKit_MB_5_1, KiKit_MB_5_2, KiKit_MB_5_3, KiKit_MB_5_4, KiKit_MB_5_5, KiKit_MB_5_6, KiKit_MB_5_7, KiKit_MB_6_1, KiKit_MB_6_2, KiKit_MB_6_3, KiKit_MB_6_4, KiKit_MB_6_5, KiKit_MB_6_6, KiKit_MB_6_7, KiKit_MB_7_1, KiKit_MB_7_2, KiKit_MB_7_3, KiKit_MB_7_4, KiKit_MB_7_5, KiKit_MB_7_6, KiKit_MB_7_7, KiKit_MB_8_1, KiKit_MB_8_2, KiKit_MB_8_3, KiKit_MB_8_4, KiKit_MB_8_5, KiKit_MB_8_6, KiKit_MB_8_7, KiKit_MB_9_1, KiKit_MB_9_2, KiKit_MB_9_3, KiKit_MB_9_4, KiKit_MB_9_5, KiKit_MB_9_6, KiKit_MB_9_7, KiKit_MB_10_1, KiKit_MB_10_2, KiKit_MB_10_3, KiKit_MB_10_4, KiKit_MB_10_5, KiKit_MB_10_6, KiKit_MB_10_7, KiKit_MB_11_1, KiKit_MB_11_2, KiKit_MB_11_3, KiKit_MB_11_4, KiKit_MB_11_5, KiKit_MB_11_6, KiKit_MB_11_7, KiKit_MB_12_1, KiKit_MB_12_2, KiKit_MB_12_3, KiKit_MB_12_4, KiKit_MB_12_5, KiKit_MB_12_6, KiKit_MB_12_7, KiKit_MB_13_1, KiKit_MB_13_2, KiKit_MB_13_3, KiKit_MB_13_4, KiKit_MB_13_5, KiKit_MB_13_6, KiKit_MB_13_7, KiKit_MB_14_1, KiKit_MB_14_2, KiKit_MB_14_3, KiKit_MB_14_4, KiKit_MB_14_5, KiKit_MB_14_6, KiKit_MB_14_7, KiKit_MB_15_1, KiKit_MB_15_2, KiKit_MB_15_3, KiKit_MB_15_4, KiKit_MB_15_5, KiKit_MB_15_6, KiKit_MB_15_7, KiKit_MB_16_1, KiKit_MB_16_2, KiKit_MB_16_3, KiKit_MB_16_4, KiKit_MB_16_5, KiKit_MB_16_6, KiKit_MB_16_7, KiKit_MB_17_1, KiKit_MB_17_2, KiKit_MB_17_3, KiKit_MB_17_4, KiKit_MB_17_5, KiKit_MB_17_6, KiKit_MB_17_7, KiKit_MB_18_1, KiKit_MB_18_2, KiKit_MB_18_3, KiKit_MB_18_4, KiKit_MB_18_5, KiKit_MB_18_6, KiKit_MB_18_7, KiKit_MB_19_2, KiKit_MB_19_3, KiKit_MB_19_4, KiKit_MB_19_5, KiKit_MB_20_2, KiKit_MB_20_3, KiKit_MB_20_4, KiKit_MB_20_5: NPTH
KiKit_TO_1, KiKit_TO_2, KiKit_TO_3, KiKit_TO_4: NPTH
Q1, Q1#2: AO3401A; SOT-23
R1, R1#2, R2#2, R2#3: 5.1k; R_0603_1608Metric
R1#3, R2, R10, R10#2, R11, R11#2: 220k; R_0603_1608Metric
R3, R4, R4#2, R12, R12#2: 1k; R_0603_1608Metric
R3#2, R3#3: 4.7k; R_0603_1608Metric
R5, R5#2: 3.3k; R_0603_1608Metric
R6, R6#2, R7, R7#2, R9, R9#2: 10k; R_0603_1608Metric
R13, R13#2, R14, R14#2, R16: 1; R_1206_3216Metric
R15: 330; R_0603_1608Metric
SW1, SW2, SW3, SW4: MX switch; SW_Cherry_MX_1.00u_PCB_Reversible
SW1#2, SW2#2, SW3#2, SW4#2: MX switch; SW_Cherry_MX_1.00u_PCB
SW5, SW5#2: RESET; SW_Push_1P1T_XKB_TS-1187A
SW6, SW6#2: BOOT; SW_Push_1P1T_XKB_TS-1187A
TP1: UART; PinHeader_1x02_P2.54mm_Vertical
TP1#2: TXD; TestPoint_Pad_1.0x1.0mm
TP2: RXD; TestPoint_Pad_1.0x1.0mm
U1, U1#2: ESP32-C3-WROOM-02-N4; ESP32-C3-WROOM-02
U2, U2#2, U5: SRV05-4; SOT-23-6
U3, U3#2: TP4054; SOT-23-5
U4, U4#2: RT9080-3.3; SOT-23-5

Connections:
Board_0-GND: C1.2, D2#3.1, J2#3.2, J3.2, R2.2, SW1.2, SW2.2, SW3.2, SW4.2
Board_0-K1: J1.2, SW1.1
Board_0-K2: J1.3, SW2.1
Board_0-K3: D1.2, J1.4, SW3.1
Board_0-K4: D1.1, J1.5, SW4.1
Board_0-LED: J1.6, R3.1
Board_0-LED_A: D2#3.2, R3.2
Board_0-VBAT: J3.1, J4.1, R1#3.1
Board_0-VBAT_SENSE: C1.1, J1.1, R1#3.2, R2.1
Board_1-3V3: C4#2.1, C5#2.1, R6.1, R7.1, R9#2.1, U1.1, U2#2.5, U4#2.5
Board_1-CC1: J1#2.A5, R1.1
Board_1-CC2: J1#2.B5, R2#3.1
Board_1-CHG_A: D1#3.2, R4.2
Board_1-EN: C6.1, R6.2, SW5.1, U1.2
Board_1-GND: C1#2.2, C2#2.2, C3#2.2, C4#2.2, C5#2.2, C6.2, C7#2.2, D3#2.1, J1#2.A1, J1#2.A12, J1#2.B1, J1#2.B12, J1#2.S1, J2#2.2, R1.2, R2#3.2, R3#3.2, R5#2.2, R11#2.2, SW1#2.2, SW2#2.2, SW3#2.2, SW4#2.2, SW5.2, SW6.2, U1.9, U1.19, U2#2.2, U3#2.2, U4#2.2
Board_1-IO2: R9#2.2, U1.16
Board_1-IO8: R7.2, U1.7
Board_1-IO9: SW6.1, U1.8
Board_1-K1: SW1#2.1, U1.15
Board_1-K2: SW2#2.1, U1.3
Board_1-K3: SW3#2.1, U1.4
Board_1-K4: SW4#2.1, U1.18
Board_1-LED: R12.1, U1.10
Board_1-LED_A: D3#2.2, R12.2
Board_1-PROG: R3#3.1, U3#2.5
Board_1-RXD: TP1.2, U1.11
Board_1-STAT: D1#3.1, U3#2.1
Board_1-TXD: TP1.1, U1.12
Board_1-USB_DN: J1#2.A7, J1#2.B7, U1.13, U2#2.3, U2#2.4
Board_1-USB_DP: J1#2.A6, J1#2.B6, U1.14, U2#2.1, U2#2.6
Board_1-VBAT: C2#2.1, D4.2, J2#2.1, Q1#2.3, R10#2.1, U3#2.3
Board_1-VBAT_SENSE: C7#2.1, R10#2.2, R11#2.1, U1.17
Board_1-VBUS: D2#2.2, J1#2.A4, J1#2.A9, J1#2.B4, J1#2.B9, Q1#2.1, R4.1, R5#2.1, R13#2.1, R14#2.1, U3#2.4
Board_1-VBUS_C: C1#2.1, R13#2.2, R14#2.2
Board_1-VSYS: C3#2.1, D2#2.1, D4.1, Q1#2.2, U4#2.1, U4#2.3
Board_2-3V3: C4.1, C5.1, J3#2.7, R6#2.1, R7#2.1, R9.1, U1#2.1, U2.5, U4.5, U5.5
Board_2-CC1: J1#3.A5, R1#2.1
Board_2-CC2: J1#3.B5, R2#2.1
Board_2-CHG_A: D1#2.2, R4#2.2
Board_2-EN: C6#2.1, R6#2.2, SW5#2.1, U1#2.2
Board_2-GND: C1#3.2, C2.2, C3.2, C4.2, C5.2, C6#2.2, C7.2, C8.2, D3.1, J1#3.A1, J1#3.A12, J1#3.B1, J1#3.B12, J1#3.S1, J2.2, J3#2.1, R1#2.2, R2#2.2, R3#2.2, R5.2, R11.2, SW5#2.2, SW6#2.2, U1#2.9, U1#2.19, U2.2, U3.2, U4.2, U5.2
Board_2-IO2: R9.2, U1#2.16
Board_2-IO8: R7#2.2, U1#2.7
Board_2-IO9: SW6#2.1, U1#2.8
Board_2-K1: J3#2.2, U1#2.15, U5.1
Board_2-K2: J3#2.3, U1#2.3, U5.3
Board_2-K3: J3#2.4, U1#2.4, U5.4
Board_2-K4: J3#2.5, U1#2.18, U5.6
Board_2-LED: R12#2.1, R15.1, U1#2.10
Board_2-LED_A: D3.2, R12#2.2
Board_2-LED_OUT: J3#2.6, R15.2
Board_2-PROG: R3#2.1, U3.5
Board_2-RXD: TP2.1, U1#2.11
Board_2-STAT: D1#2.1, U3.1
Board_2-TXD: TP1#2.1, U1#2.12
Board_2-USB_DN: J1#3.A7, J1#3.B7, U1#2.13, U2.3, U2.4
Board_2-USB_DP: J1#3.A6, J1#3.B6, U1#2.14, U2.1, U2.6
Board_2-VBAT: C2.1, D4#2.2, J2.1, Q1.3, R10.1, U3.3
Board_2-VBAT_SENSE: C7.1, R10.2, R11.1, U1#2.17
Board_2-VBUS: D2.2, J1#3.A4, J1#3.A9, J1#3.B4, J1#3.B9, Q1.1, R4#2.1, R5.1, R13.1, R14.1, U3.4
Board_2-VBUS_C: C1#3.1, R13.2, R14.2
Board_2-VSYS: C3.1, D2.1, D4#2.1, Q1.2, R16.1, U4.1, U4.3
Board_2-VSYS_D: C8.1, R16.2
