EdgeCoil/tune-button/(commit log)

2026-10-19 Protocol v1 (signed press advert, pairing) and XIAO ESP32-C3 firmware
    Native tests check the SHA-256/HMAC implementation against RFC 4231 and the
    press encoder against protocol/vectors.json.
2026-10-19 Android companion app: background PendingIntent scan, HMAC/replay checks, Spotify PKCE
    PressReceiver verifies each advert against the paired key and counter and hands
    new presses to an expedited WorkManager job, which likes the current item
    (PUT /me/library) or adds it to the chosen playlist (POST /playlists/{id}/items).
    Unit tests run against protocol/vectors.json.
2026-10-19 Wiring guide, parametric case with STLs, design notes, README, licensing
    Case is OpenSCAD (CERN-OHL-S-2.0); both STLs render as valid 2-manifolds.
    docs/design.md carries the Phase-0 latency procedure, security reasoning,
    an estimated power budget and the bench-test table. REUSE 3.3 compliant.
    [tune-button-base.stl, tune-button-lid.stl, tune-button.scad]
2026-10-21 One-button build; pairing keeps the old key unless a phone completes it
    TB_BUTTONS=1 (env xiao_esp32c3_1btn): like on D1 only, sent on release;
    a 5 s hold pairs. D2 is left out of the deep-sleep wake mask.
    Pairing now holds the new id/key in RAM and stores it only after the
    phone's encrypted read. Before, an aborted or accidental pairing
    silently unpaired the working phone, which a single-button hold made
    easy. merge.sh takes the env name. Docs and bench table updated.
2026-10-21 App: pairing hint covers the one-button hold; first latency reading
    The Pair label and scan status said only "hold both buttons 3 s".
    design.md gets a measurements table: one locked-screen press on Balanced
    was heard in 0.83 s.
2026-10-21 One-button case: round puck for a 22 mm panel-mount button
    Ø76 × 47 mm. Base carries the LiPo flat and the XIAO on rails beside it,
    USB-C through the wall via a thin lip and a plug recess; the button hangs
    from the 3 mm top. Three M2 posts run the full height so the body prints
    top-down with no supports. Battery W/L and thread Ø measured; cell
    thickness and switch depth are marked ESTIMATE. Asserts stop the render
    if the battery corner or a post would collide. Both STLs 2-manifold.
    [tune-button-1btn-base.stl, tune-button-1btn-body.stl, tune-button-1btn.scad]
2026-10-21 Four-key PCBs: XIAO-socket and on-board ESP32-C3 versions, generated from one netlist
    hardware/pcb/gen.py writes a KiCad schematic and board for each from the same parts list;
    route.py autoroutes with Freerouting and stitches the ground pours; build.sh runs ERC, DRC with
    schematic parity, and exports fab files. Rev A: both clean in KiCad, nothing built yet.
    [tune-button-c3.kicad_pcb, tune-button-c3.kicad_sch, tune-button-xiao.kicad_pcb, tune-button-xiao.kicad_sch]
2026-10-21 PCBs: keep screw heads and labels clear of the keycaps
    Mounting holes move out from under the caps (both boards 2.5 mm longer), and part labels are placed
    automatically beside each part, off pads, bodies and the XIAO's outline.
    [tune-button-c3.kicad_pcb, tune-button-xiao.kicad_pcb]
2026-10-21 C3 PCB: no board under the antenna, USB-C to the bottom edge
    The top-left corner is cut away under the module's antenna, as Espressif's layout guide prefers,
    and USB-C moves to the middle of the bottom edge (about 70 mm from the antenna) with its ESD
    part and CC resistors between the lower switches. The receptacle's face now sits 0.2 mm proud of
    the edge so a plug's moulding clears the board.
    [tune-button-c3.kicad_pcb, tune-button-xiao.kicad_pcb]
2026-10-21 C3 PCB: JLC Basic/Preferred parts where a drop-in exists, LCSC numbers, JLC BOM and CPL
    TP4054 for MCP73831, XC6206 for MCP1700 and SRV05-4 for USBLC6-2SC6, each with the same footprint
    and pinout. Every assembled part carries its LCSC number; the build writes JLC-format BOM and
    placement files listing only those parts. Only the module, USB-C and JST sockets remain Extended.
    [tune-button-c3.kicad_pcb, tune-button-c3.kicad_sch, tune-button-xiao.kicad_pcb, tune-button-xiao.kicad_sch]
2026-10-21 C3 PCB: switches and LEDs on the back, electronics on the front, EdgeCoil mark on the key side
    The MX switches mount on the back (mirrored so K1 is still top left from the key side), and only
    their leads and posts need room on the front, guarded by part-free rule areas. That lets the keys
    sit behind the electronics: the board is 69.5 mm long instead of 80.5. The two LEDs move to the key
    side as hand-soldered 0805s; the battery socket and UART pads sit between the key rows. The key side
    carries the mark, the board name and LED labels; part labels are placed per side and kept off the
    antenna notch.
    [tune-button-c3.kicad_pcb, tune-button-c3.kicad_sch, tune-button-xiao.kicad_pcb]
2026-10-21 pcb: MCP1700 regulator, edgecoil.dev on the silkscreen, mark under its own licence
    The EdgeCoil mark, name and URL are all rights reserved and outside CERN-OHL-S; derivatives must
    remove them. The C3 board's regulator goes back to the 250 mA MCP1700 (C39051, Extended).
    [tune-button-c3.kicad_pcb, tune-button-c3.kicad_sch, tune-button-xiao.kicad_pcb]
2026-10-21 pcb: DFM fixes from audit; artwork clear of drilled holes
    - fab_jlc.py: per-part CPL rotation and origin corrections (MCP1700, AO3401A, SRV05-4, TP4054,
    USB-C), checked against JLC's own footprints; the SRV05-4 one would have shorted VBUS.
    - Paste on the USB-C shell slots; thermal spokes on all pour pads; copper 0.3 mm from the edge.
    - Silkscreen text 1.0 mm / 0.15 mm; switch-pin keep-outs 2.5 mm, R10/R11/C7 moved for iron room.
    - Via-free rule areas under back artwork, honoured by the stitcher; the build refuses a footprint
    hole under artwork. C3 mark moved off the module's ground vias; XIAO text off SW4's pins.
    - No drill maps or back paste in the gerber zip.
    [tune-button-c3.kicad_pcb, tune-button-xiao.kicad_pcb]
2026-10-21 pcb (c3): power-path fixes from simulation
    - SRV05-4 rail on 3V3, not VBUS: on battery the D+ pull-up leaked onto VBUS (2.6 V simulated)
    and half turned off the battery FET.
    - 1 ohm in series with the charger's input capacitor: plug-in ringing peaked near 7 V, past the
    regulator's 6.5 V limit.
    - R5 100k -> 10k: Q1 turns back on ~3 ms after unplugging rather than ~15 ms, and stays on
    against D2's leakage when warm.
    [tune-button-c3.kicad_pcb, tune-button-c3.kicad_sch, tune-button-xiao.kicad_pcb]
2026-10-21 pcb (c3): RT9080 600 mA regulator
    Covers Wi-Fi's ~350 mA transmit peaks (current limit >= 610 mA, 2 uA quiescent); SOT-23-5 with the
    AP2112K symbol's pinout, EN tied on. JLC CPL rotation +270, from JLC's own footprint.
    [tune-button-c3.kicad_pcb, tune-button-c3.kicad_sch, tune-button-xiao.kicad_pcb]
2026-10-21 pcb: fixes from the second DFM audit and visual review
    - JLC BOM: no designator ranges (KiCad wrote R5-R7, so the CPL lost R5/R6/R7); fab_jlc.py now
    refuses a BOM part with no placement.
    - Stitching vias kept off SMD pad openings (two were in the module ground pad's paste).
    - Logo drawn as rows at the stroke pitch with caps inset, so gaps keep their size; 15 mm wide.
    - Labels only where their own part is the nearest body (R13 and U4 were ambiguous).
    - Battery + marks off the pads; USB-C slot paste overprinted 0.2 mm; footprint silk >= 0.15 mm.
    - C3 board 70.1 mm long so the USB-C legs clear the switch housings by 0.3 mm.
    - Stop tracking __pycache__.
    [tune-button-c3.kicad_pcb, tune-button-xiao.kicad_pcb]
2026-10-21 pcb: README board size
2026-10-21 pcb (c3): fixes from the second simulation pass
    - C1 4.7u -> 10u 0805 (C15850, Basic): with R13, plug-in ringing on low-resistance cables peaks
    around 5.6 V instead of 6.1 V (RT9080 absolute max 6.5 V).
    - D4, a 1N5819WS across Q1: in the ~3-5 ms after unplugging, before Q1 turns on, the cell feeds
    VSYS through 0.35 V rather than the body diode's 0.6 V, so a Wi-Fi burst there stays above
    brown-out at a 3.4 V cell.
    [tune-button-c3.kicad_pcb, tune-button-c3.kicad_sch, tune-button-xiao.kicad_pcb]
2026-10-21 pcb: black solder mask, white legend in the board stackup
    [tune-button-c3.kicad_pcb, tune-button-xiao.kicad_pcb]
2026-10-21 pcb: third DFM audit and visual fixes
    - JLCJLCJLCJLC order-number marker (C3 electronics side, XIAO back); README: black mask,
    lead-free HASL, 'Specify a location', overhang remark.
    - Logo scaled by the mark's own extent (15 mm printed, was 12.4); vias 1 mm clear of back art.
    - D1/D3 labels merged into the back text; keycaps are label obstacles on front-key boards.
    - USB-C slot paste overprint 0.12 mm (0.15 mm stencil web).
    [tune-button-c3.kicad_pcb, tune-button-xiao.kicad_pcb]
2026-10-21 pcb (c3): fixes from the third simulation pass
    - C1's damping resistor 1 -> 0.5 ohm (R13 + R14, two Basic 1 ohm): with 1 ohm a stiff 5.5 V
    source and no cell rang VSYS to 6.8 V, past the RT9080's 6.5 V; 0.47 ohm simulated under 6.4 V
    on every cable corner.
    - R5 10k -> 3.3k: the bigger C1 had stretched the unplug gap to 13-28 ms; ~5-7 ms again.
    - README: D4's hot reverse leakage means the cell's protection board is the overcharge backstop.
    [tune-button-c3.kicad_pcb, tune-button-c3.kicad_sch, tune-button-xiao.kicad_pcb]
2026-10-21 pcb: fourth DFM audit fixes
    - route.py stitches with pour islands kept, then removes the ones still unconnected: a 44 mm2 pocket
    of back GND fenced in by tracks near the module was being dropped before it could get a via.
    - Zero-length track segments pruned.
    - Logo: gaps narrower than the 0.15 mm legend limit are opened to 0.15 rather than left to fill.
    [tune-button-c3.kicad_pcb, tune-button-xiao.kicad_pcb]
2026-10-22 pcb: fixes from the fourth simulation pass
    - C3: R13/R14 (plug-in damping) are 1206, not 0603. Each takes a ~35 W,
    ~50 uJ pulse per plug-in from a stiff source, about twice an 0603's
    repetitive pulse rating. Moved flat above U4; C1 nudged down.
    - XIAO: D1 is a 1N4148WS, not a BAT54W. A Schottky's reverse leakage
    dragged K4 low while K3 was held, from about 60 C.
    - R5 comment: the unplug gap is 5-8 ms, up to ~15 ms at tolerance extremes.
    - wiring.md: the divider holds GPIO2 below the high threshold; it doesn't
    select the boot mode on the C3, so that is fine.
    - README: the firmware pin map doesn't match either board yet, and a low
    cell sags the C3 rail on Wi-Fi-sized bursts.
    [tune-button-c3.kicad_pcb, tune-button-c3.kicad_sch, tune-button-xiao.kicad_pcb, tune-button-xiao.kicad_sch]
2026-10-22 pcb: fixes from the fifth audit
    - XIAO D1: LCSC C2128 (Changjing 1N4148WS, Basic), so it appears in the JLC
    BOM/CPL. Its VF max of 0.715 V at 1 mA is what the K4 press needs to read
    low at -20 C; the README says so. Hand-soldering footprint, as that board is.
    - Labels: a label must be nearer its own part than any other by 0.25 mm,
    measured edge to edge (it was centre to body). C1's label passes that and
    stays beside C1; U4's, which the first try at this rule hid, is placed.
    - route.py drops exactly repeated track segments from the saved board
    (removing them through pcbnew's bindings crashes it later in the run).
    - variant_xiao docstring no longer says Schottky.
    [tune-button-c3.kicad_pcb, tune-button-xiao.kicad_pcb, tune-button-xiao.kicad_sch]
2026-10-22 pcb (c3): USB-C at HRO's recommended board edge
    HRO's layout puts the board edge 5.79 mm from the receptacle's locating
    holes, so its face overhangs by 0.46 mm. It was 6.05 mm (0.2 mm overhang),
    which JLC's +-0.2 mm outline tolerance could take to flush, leaving a plug's
    moulding nothing to clear the board by. The board is 0.26 mm shorter
    (46 x 69.7 mm): the USB-C keeps its place relative to the keys, and what is
    placed from the bottom edge (U2, R1, R2, the lower mounting holes) moves up
    with it.
    [tune-button-c3.kicad_pcb]
2026-10-22 pcb: fixes from the sixth DFM audit
    - Back-side SMD parts (the hand-soldered LEDs) get a rule area between
    their pads: no tracks, vias or pour there. The re-route had threaded
    VBAT between D3's pads, beside its GND pad, where a solder bridge would
    short the battery.
    - Stitching now aims for two GND vias at least 2 mm apart in every pour
    island, not one. U3's ground pad (the charger's heat path) sits on a
    30 mm2 island with three vias; it had been on a 10 mm2 one with one.
    [tune-button-c3.kicad_pcb, tune-button-xiao.kicad_pcb]
2026-10-22 c3: keep tracks out from under the USB-C shell; lay the D+/D- crossover
    Round-7 DFM: VBUS ran under J1's grounded shell, insulated only by mask. A
    track-free rule area now covers the body from 1.2 mm past the pad tips. With it
    the router could no longer join the interleaved D-/D+ pads reliably, so gen.py
    lays that crossover itself (D+ across the inner tips, D- through two vias at the
    outer tips) and locks it; route.py keeps locked tracks and fails if the session
    import drops one.
    [tune-button-c3.kicad_pcb]
2026-10-22 pcb: round-8 audit suggestions
    - J1 keepout starts at the shell's metal floor (0.7 mm past the pad tips);
    the D- stubs stop short of it.
    - VBUS pad pairs joined through their own power vias and a back-side link,
    so VBUS no longer runs along the GND pads and shell legs.
    - D+ link 0.5 mm clear of the A7/B7 tips.
    - U2 (ESD) gets its own GND via off its ground pin; U2 moves 0.5 mm up for it.
    - Stitcher gives a via-less GND island one wherever a via fits in both pours.
    - No vias within 0.6 mm of back-side hand-soldered pads, or under part labels
    and the JLC mark.
    - route.py drops zero-length segments with the duplicates.
    [tune-button-c3.kicad_pcb, tune-button-xiao.kicad_pcb]
2026-10-22 pcb: round-9 audit fixes; freeze the routing
    Round 9 suggestions: keep back tracks off the logo, vias out from under all
    front text, standard VBUS vias 0.5 mm out, drop sub-10 um segments, space
    stitching vias by copper and anchor islands to any GND via, and reject
    autoroute attempts that drop back-plane pour or run another net within
    0.4 mm of a switch pin.
    Freerouting lays the board out afresh on every run, so each review was of a
    new layout. route.py now replays a reviewed routing from <board>/routing.json;
    --reroute autoroutes, --freeze records. The back-part via margin is 0.25 mm
    (vias are tented; at 0.6 mm the router ran out of room). XIAO: K3 moved off
    SW1 pin 1; C3: two stitching vi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
    [tune-button-c3.kicad_pcb, tune-button-xiao.kicad_pcb]
2026-10-22 pcb: round-10 audit fixes
    - The pin-gap check covers every hand-soldered through-hole pin (no LCSC
    number): switches on both layers, headers and sockets on the solder side,
    0.4 mm, or 0.29 mm for a track crossing a header row between two pins.
    - Replaying routing.json runs the pin-gap and lost-pour checks too, so a
    hand edit has to meet them.
    - XIAO: K2 moved 0.4 mm clear of J1 pins 4-7; K4 centred between J2 pins 4
    and 5. C3: K4 moved 0.4 mm clear of TP1.
    - C3: second GND vias on the strip beside D+ (R2) and on the R5 island.
    - Segments under 0.02 mm are dropped; two such were removed.
    - README: nylon washers or standoffs at the C3's mounting holes (H3 has
    tracks within 2 mm).
    [tune-button-c3.kicad_pcb, tune-button-xiao.kicad_pcb]
2026-10-22 pcb: hold the ground pour 0.4 mm off hand-soldered pins (round-11 audit)
    A custom DRC rule (gen.py writes <board>.kicad_dru) gives through-hole pads 0.4 mm clearance to zones, matching the pin-gap check for tracks. Every such pad off GND is a hand-soldered pin.
    [tune-button-c3.kicad_pcb, tune-button-xiao.kicad_pcb]
2026-10-24 pcb: c3-jst, the C3 board with its buttons on a JST connector
    The c3's circuit with the four MX switches taken off the board: the buttons wire to
    a 7-pin JST PH (GND, K1-K4, LED through 1k, 3V3), whose key lines get their own
    SRV05-4. Every part is on the front and JLC fits them all, the LEDs now included
    (C84256). 36 x 50 mm against the c3's 46 x 70; at 34 x 47 the autorouter never came
    out clean in 32 attempts. Routing frozen in c3-jst/routing.json.
    gen.py takes the board width per variant, and keeps test pads out of the schematic
    BOM as their footprint already is. The c3 and xiao boards regenerate unchanged.
    [tune-button-c3-jst.kicad_pcb, tune-button-c3-jst.kicad_sch]
2026-10-24 pcb (c3-jst): round-1 audit fixes
    JLC CPL rotates the 7-pin JST 180 degrees (JLC draws it pins-down; at 0 it would be
    fitted backwards). A ground via 1.7 mm from U5's ground pin, where the ESD return ran
    7.7 mm to the nearest via; the J3 pin legend moves to a column on the right so its
    keepout leaves room. R15 330 ohm, so a lit button gets about 4 mA. Pin-1 mark clear
    of J3's outline; TP1/TP2/U3 labels hidden. README covers the third board: JLC order
    notes, rails, mounting, UART ground, the 3.6 V cutoff.
    [tune-button-c3-jst.kicad_pcb, tune-button-c3-jst.kicad_sch]
2026-10-24 pcb: round-2 audit wording fixes
    Three boards, not two, in the README, build.sh and gen.py's docstring (which also named a
    check.py that no longer exists; build.sh's DRC parity check does that job). README: the
    "+" marks the battery socket, and J3's LED pin is the one wire with no clamp.
    [gen.py]
2026-10-24 pcb: round-3 audit fixes (c3-jst)
    README: a wrong SRV05-4 rotation shorts the 3V3 rail (its rail moved off VBUS in
    c5bdc1c), and the JST sockets stand 5.5 mm, not 4.8. c3-jst hides SW6's reference,
    which sat against the unlabelled U3 and read as its label; BOOT names the switch.
    [tune-button-c3-jst.kicad_pcb]
2026-10-24 pcb: README, mouse-bite rails for both C3 boards (round-13 audit)
    The c3's pour is 0.3 mm from its edges too, so the V-cut warning applies to it, not
    only to c3-jst.
2026-10-24 pcb: round-4 audit fixes (c3-jst)
    README places c3-jst's mouse-bite tabs where no track runs along the edge (K4 runs
    0.4 mm inside most of the right edge). R9's reference is hidden: its only spot read
    as the unlabelled R14's.
    [tune-button-c3-jst.kicad_pcb]
2026-10-24 pcb: c3-jst labels must be clearly their own part's (round-5 audit)
    Three audit rounds in a row found a c3-jst label that read as a neighbour's (R9, C4,
    and U3/SW6 before). Fix the class: place_labels takes the ownership margin per board,
    0.5 mm on c3-jst instead of 0.25, and treats vias (the frozen ones and gen.py's own) as
    obstacles, since every label gets a via-free zone under it. A label with no clear spot
    is hidden. The c3 and xiao boards regenerate unchanged.
    [tune-button-c3-jst.kicad_pcb]
2026-10-24 pcb: one panel of all three boards for Standard PCBA; JLC fits the XIAO board's parts
    panel.py builds a 146 x 72 mm KiKit panel (XIAO, C3, c3-jst, 5 mm rails left and right,
    JLC tooling holes and fiducials on the rails) from the committed boards. Mouse-bite tabs
    go only where no track, via or pad is within 1 mm of the edge; the pour is held back
    around each, and a narrow tab gets no fillet so its bites stay inside the clear span.
    It writes the panel's gerbers and JLC BOM/CPL, designators prefixed by board, each part
    placed as on its own board through fab_jlc.jlc_place (now importable).
    The XIAO board's battery JST, 1x7 sockets and 2-pin header get LCSC numbers, with the
    rotation and centre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
    [tune-button-panel.kicad_pcb, tune-button-xiao.kicad_pcb, tune-button-xiao.kicad_sch]
2026-10-24 pcb: panel round-1 audit fixes
    A 5 mm frame (bars across the top and bottom joining the rails, clear of the overhangs),
    so the right rail no longer hangs on one narrow tab. Tabs keep away from mounting holes
    (a tab sat on the c3's H4) and leave room for their fillets; bites sit 0.25 mm inside the
    board; tab keepouts run 1 mm past the end bites. Fiducials 3.85 mm in (JLC's minimum),
    tooling holes with a 1.448 mm mask opening, only the c3's JLC marker kept, panel/fab
    cleared before export. free_spans uses fab bodies (the courtyard test was never built).
    route.py's crowded_pins now checks every through-hole part not reflowed in paste, not
    only those without an LCSC number, so the XIAO sockets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
    [tune-button-c3-jst.kicad_pcb, tune-button-c3.kicad_pcb, tune-button-panel.kicad_pcb, tune-button-xiao.kicad_pcb]
2026-10-24 pcb: panel round-2 audit fixes
    The top bar had fused onto the c3: the milling fillets bridge any gap under two fillets.
    Bars now keep 2.5 mm from every board edge as well as 1.5 mm from overhanging parts, and
    panel.py checks that each board is joined only at its tabs. Every tab has fillets with
    bites round them (the mill rounds them anyway), so a tab needs its width plus both fillets
    of clear edge. free_spans works on all four edges, and the boards are tabbed to the top and
    bottom bars where they are clear; c3-jst's right edge, which has no room once fillets count,
    gets no tab, and c3-jst hangs from the c3 and the bottom bar. Tooling-hole mask expansion
    0.148 mm (it was passed as the opening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
    [tune-button-c3-jst.kicad_pcb, tune-button-c3.kicad_pcb, tune-button-panel.kicad_pcb, tune-button-xiao.kicad_pcb]
2026-10-24 pcb: panel round-3 audit fixes
    Two tabs end 1.2 mm from connector anchor pads (c3 J2, c3-jst J3), inside JLC's 2 mm
    keep-out, and no other edge is free there: panel.py finds tabs within 2.25 mm of a
    connector's pads and puts their bites 0.25 mm outside the board, and the README says to
    cut those two with flush cutters. 6 mm rails and bars, so the fiducials sit 4.35 mm in
    (JLC's 3.35 mm to the opening). The self-check now tests each piece of material along a
    board's edge against its own tab, not a per-board total. Bite pitch 0.75 mm. README:
    mounting-hole wording matches the 2 mm rule.
    [tune-button-panel.kicad_pcb]
2026-10-24 pcb: panel round-4 audit fixes (README)
    Bite pitch stays at what KiKit gives for 0.8 mm (0.80-0.83 mm): a closer pitch with 0.5 mm
    holes breaks the 0.25 mm hole-to-hole rule, and the README now says about 0.8 mm. README:
    the two cut tabs' bites stop where the fillets start; JLC's through-hole fee is a fixed
    hand-soldering charge plus a per-joint rate; the XIAO column lists the battery header.
    [tune-button-panel.kicad_pcb]
2026-10-24 pcb: pin KiKit 1.8.1 for the panel (round-5 audit)
    The panel depends on KiKit's internals (bite spacing among them), and KiKit needs KiCad's
    pcbnew, so the README and panel.py name the version and the venv set-up.
2026-10-24 pcb: c3-jst moves C1 and its damper beside the USB-C, rerouted
    Up at the top right, C1 (the VBUS input capacitor) and R13/R14 were about 45 mm of track
    (~36 nH) from J1. The routed-copper simulation showed a hot-plug with no cell ringing VBUS
    to 9.7-11.7 V (the c3 sees 5.5-5.9 V). They now sit above J1's left VBUS pins. Placement
    changed, so the board is rerouted (clean on attempt 4) and routing.json re-frozen.
    [tune-button-c3-jst.kicad_pcb]
2026-10-24 pcb: c3-jst round-8 audit fixes; panel rebuilt with the moved C1
    - README: H2 now needs a nylon screw or washers (K2 and VBUS run 1.6 mm from its centre), and the
    c3-jst tab-placement remark follows the new copper.
    - Back pour kept off the top edge above the 3V3 track at the antenna base (was a 0.29 mm strip).
    - K4 via moved 0.1 mm off K3's (0.60 mm hole to hole).
    - panel.py: no tab within 3 mm of an 0805-or-larger ceramic capacitor. Panel rebuilt: c3-jst has six
    tabs, three of them cut-not-snap.
    [tune-button-c3-jst.kicad_pcb, tune-button-panel.kicad_pcb]
2026-10-24 pcb: c3-jst round-9 audit fixes
    - README: the single-board right-edge tab windows at 25-29 and 39-45 mm are inside the 2 mm
    connector keep-out, so cut those tabs rather than snapping them; H1's wording names the pour.
    - K4: the 0.03 mm stub left by the via move is gone; the diagonal starts at the via, at 45 deg.
    - Panel rebuilt with it.
    [tune-button-c3-jst.kicad_pcb, tune-button-panel.kicad_pcb]
2026-10-24 pcb: panel round-7 audit fixes
    - Tabs prefer a place at least 2.25 mm from a connector's pads within their free span: c3-jst's
    bottom tab moves clear of J3, leaving two cut-don't-snap tabs (both on c3-jst's right edge).
    - Note that pour a tab keepout cuts off is dropped as an island.
    [tune-button-panel.kicad_pcb]
2026-10-24 pcb: panel round-8 audit fix: both cut tabs are by J2's anchor pads (README, comment)
    [panel.py]
2026-10-24 pcb: c3-jst: RC damper (R16 1 ohm + C8 10 uF) at the RT9080 input, rerouted
    sim12 had VSYS ringing to 6.6-6.7 V on a no-cell hot-plug against the RT9080's 6.5 V; sim13 puts
    the damped worst case at 5.86 V. Panel rebuilt; README tab gaps and cutoff figures updated.
    [tune-button-c3-jst.kicad_pcb, tune-button-c3-jst.kicad_sch, tune-button-panel.kicad_pcb]
2026-10-24 pcb: c3-jst round-11 audit fixes (README: right-edge tab windows lose 3-8 mm to C8; H2's nets; C1 wording)
2026-10-24 pcb: panel round-10 audit fixes: no tab within 1.5 mm of a pad (JLC mouse-bite rule), asserted
    The reroute let c3-jst's top tab slide next to the module's corner pad (0.81 mm from a bite).
    free_spans now holds every pad 1.5 mm from the bite line and panel.py exits if a tab ends up
    closer. c3-jst gets five tabs; README tab text and pour-fragment comment updated.
    [tune-button-panel.kicad_pcb]
2026-10-24 pcb: panel round-11 audit fixes (text): cut-tab bite pitch, standalone c3-jst right-edge windows at the 1.5 mm pad rule, tab width note, C8 by the top tab
    [panel.py]
2026-10-25 pcb: panel round-12 audit fix (README: panel order options; C3 points to the panel)
2026-10-25 pcb: no hole under 0.3 mm (JLC standard): the module's 12 thermal vias go 0.2 -> 0.3 mm, DRC minimum 0.3
    JLC prices 0.2 mm holes as an option: $20 -> $70 for the panel. Only those pad drills change;
    copper, nets and positions are identical on all three boards.
    [tune-button-c3-jst.kicad_pcb, tune-button-c3.kicad_pcb, tune-button-panel.kicad_pcb, tune-button-xiao.kicad_pcb]
2026-10-25 pcb: README names the standard via option (0.3mm/(0.4/0.45mm)) in both order lists (drill audit S1)
2026-10-25 pcb: README: via option as its own clause in the single-board order line
2026-10-25 pcb: no JLCJLCJLCJLC order-number marker on any board (ordered with Remove Mark)
    Only the marker text and its no-via rule area go; parts, copper and fills are identical, and the
    BOM and CPL are unchanged. README says to choose Remove Mark.
    [tune-button-c3-jst.kicad_pcb, tune-button-c3.kicad_pcb, tune-button-panel.kicad_pcb, tune-button-xiao.kicad_pcb]
2026-10-25 pcb: c3-jst test pads' silk squares to the fab layer (JLC DFM: silk 0.12 mm from pad)
    Only TP1/TP2's four silk lines each move; copper, parts and fills are unchanged. No top silk is
    now within 0.13 mm of a pad.
    [tune-button-c3-jst.kicad_pcb, tune-button-c3.kicad_pcb, tune-button-panel.kicad_pcb, tune-button-xiao.kicad_pcb]
2026-10-25 pcb: README: rev A ordered from tag rev-a; arrival checks; the C3's hot-plug margin for rev B
2026-10-25 READMEs rewritten for readability; status: works end to end on a one-button XIAO
    Top README: what it is, status (a locked Samsung heard a press in 0.8 s and liked the song), what
    you need, setup, use, hardware options. PCB README: status and arrival checks first, ordering
    as the panel with single-board and panel-layout details folded, J3 pinout table, mounting and
    design notes as lists. No facts changed.
2026-10-25 3D renders of the three boards in the READMEs (docs/renders, CC BY 4.0)
2026-10-25 pcb README: the C3's hot-plug margin with Monte Carlo, and the two rev B options
2026-10-25 Four keys: press, hold and double press, playback control, and a key-grid app screen
    Firmware
    - Builds for each board: xiao_board (K1-K4 on D1-D4, LED on D5) and c3_board (GPIO3/4/5/0,
    LED on GPIO10), alongside the hand-wired one- and two-button builds.
    - gesture.cpp: press / hold (600 ms) / double press (300 ms) per key. A key waits only for the
    gestures it has an action for, so an unassigned key still sends on press-down.
    - Protocol version 2: each advert also names the two events before it (authenticated), so quick
    presses aren't lost to the phone's scan gaps. Still a legacy advert (29 of 31 bytes).
    - Key settings: a pairing-mode characteristic, written with an HMAC tag under the pa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
2026-10-30 Build through the shared edgecoil_pcb pipeline (vendored): all three boards and the panel unchanged
    gen.py keeps the parts, placement and variants plus a Config that holds rev A's behaviour (A3
    sheet, no silk trim, the older label rules, replay checks reporting only). Each board and the
    panel rebuild canonically identical to main, with identical schematics, project files, BOM and CPL.
    The stricter checks, reporting only, find in rev A: c3 routing has 2 redundant GND segments;
    c3-jst has 6 (GND, K2, VBAT_SENSE, VSYS) and a TXD track end joined only by overlapping copper;
    c3-jst's schematic draws SW6, TP1 and TP2 past the A3 sheet's edge. All are rev B items.
2026-10-30 build.sh: build in UTC, so gerber and drill timestamps carry no timezone
2026-10-30 vendor/: edgecoil_pcb 798a589 (refuses frozen copper KiCad would re-net; footprint-keyed JLC corrections); boards unchanged
2026-11-02 README: order single boards with Economic; the panel's Standard-only premise was never checked
    JLC offered Economic for two later ESP32-C3-WROOM-02 boards. Only the
    Wiegand Bridge's ESP32-S3 module was refused it.
2026-11-02 CI: rebuild the three boards, prove each is the committed board, build the panel
    GitHub-hosted runner, KiCad 9.0.2 pinned by digest, frozen routing
    replayed. A via moved by 1 um must fail the comparison; fab outputs must
    exist, be plausibly sized and carry only UTC timestamps; JLC placements
    checked pad by pad. The panel is built and checked but not compared
    exactly: KiKit's geometry varies by ~10 nm between machines.
2026-11-04 Layered acrylic cases for the three four-key boards
    stack.scad draws each case as a stack of 3 mm laser-cut layers, through-
    bolted at the corners: xiao (11 layers, a visor over the XIAO), c3 (8)
    and c3-jst under four 22 mm arcade buttons (17, or 6 plus a printed
    wall). The MX plate's top is 5.0 mm above the key face; the board hangs
    from it by its switches and rests on printed spacers. Cells and battery
    plugs sit in pockets; the c3's antenna-corner bolt is nylon.
    check-stack.py intersects every KiCad footprint (plus cells, plugs,
    keycaps and buttons) with every layer; it found J4 and TP1 clashes,
    now relieved, and fails on deliberately broken designs. Not yet cut.
    [sheet.dxf, spacers.stl, stack.scad, wall.stl]
2026-11-04 Printed case for the c3 board, from the stack's geometry
    tune-button-c3-printed.scad includes stack.scad for the board, cell,
    pockets, USB-C slot and heights, and prints a base (walls, spacers, cell
    fence) and a top (1.5 mm MX plate, so the clips latch, plus the bezel).
    Three M2 self-tapping screws; a peg instead of a screw at the antenna
    corner. check-stack.py now checks both printed parts too, and fails on
    the same deliberate breakages.
    [tune-button-c3-base.stl, tune-button-c3-printed.scad, tune-button-c3-top.stl]
2026-11-04 Printed c3 case: M3 screws into heat-set inserts, lid clamps the board
    The lid's top face is now the MX plate (1.5 mm), with a skirt, corner bosses
    and four posts underneath. The posts press the board's key face onto the
    base's spacers at its four mounting holes. Three M3 x 8 socket head cap
    screws go through counterbores in the lid into M3 heat-set inserts in the
    base; the antenna corner keeps a printed peg. The parting line drops to
    z = 15, so the lid corners are 6 mm thick (2.8 mm under each head, 5.2 mm
    of thread in the insert). Walls grow to 5.5 mm so the bottom-right insert
    boss clears the board's corner. No bezel, so the lid prints top face down
    in one piece without supports; the lid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
    [tune-button-c3-base.stl, tune-button-c3-lid.stl, tune-button-c3-printed.scad, tune-button-c3-top.stl]
2026-11-04 Printed c3 case: chamfers, fillets and a bridging layer for printing
    - 0.6 mm chamfer on each part's bed edge (elephant foot); 0.4 mm on both
    outer edges at the parting line.
    - 1 mm root fillets on the 12 mm board spacers and the lid's posts.
    - Lead-ins on the insert holes, the peg and its socket; chamfered pin tips.
    - 0.3 mm chamfer on the MX holes at the top face (the flange still bears).
    - A 0.2 mm membrane closes each screw hole at the bottom of its
    counterbore, so the head seat bridges cleanly when the lid prints top
    face down; push it out before fitting the screws.
    check-stack.py passes: no part enters the board's parts or the board, and
    the clamp still closes at all four holes.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
    [tune-button-c3-base.stl, tune-button-c3-lid.stl, tune-button-c3-printed.scad]
2026-11-04 Printed xiao case: base, lid and a hood over the XIAO and its antenna
    The printed case becomes tune-button-printed.scad, one file for both
    variants. For xiao the lid stops short of the XIAO, and a hood carries
    the plate line over it: the roof clears the module and USB, a 0.4 mm
    pocket under the roof takes the stick-on antenna, and two brackets from
    the back wall clamp the board at the back holes where the lid's posts
    can't reach. Four M3 x 8 into heat-set inserts.
    check-stack.py checks each printed part against the KiCad courtyards and
    the board, the parts against each other by overlap volume, and that a
    post or bracket bears on the board at every mounting hole. Mutations:
    hood_top=30 colli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
    [tune-button-c3-printed.scad, tune-button-printed.scad, tune-button-xiao-base.stl, tune-button-xiao-hood.stl, tune-button-xiao-lid.stl]
2026-11-05 Firmware: stay awake on a computer's USB, and log each wake and key
    When a wake ends, the button now checks for a USB host (the 1 ms frames
    the C3's USB serial sees; a plain charger sends none) and, while one is
    there, waits awake for the next press instead of sleeping. The serial
    port stays up for logs and uploads. After a reset it waits 1.5 s for the
    host to enumerate it before deciding.
    The firmware now starts the USB serial itself (the core only does in
    the other USB mode, so every print was dropped) and logs each wake and
    each code sent. -DTB_USB_HEARTBEAT adds the raw key state once a second.
    On a c3 rev A board: blank module flashed, all four keys send 01-04,
    stays awake on USB thro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
    [main.cpp]
2026-11-05 Printed cases: corner reliefs in the MX holes, and a hole-size gauge
    On the first printed lid the switches would not go fully into the 14.1
    mm holes, so they stopped part way and the lid stood about 3 mm proud
    of the base. A printed square hole has rounded corners that the switch's
    square body jams on, and the first layer squashes into the hole on the
    face the switches enter (the lid prints top face down).
    Each MX hole now has a 1 mm circle at each corner (one shared mx_cut()
    module), and tune-button-mx-gauge.scad prints the same plate with holes
    of 14.0, 14.1, 14.2 and 14.3 mm so mx_hole can be set from a real print.
    Only the lids change; bases and hood are unchanged.
    [tune-button-c3-lid.stl, tune-button-mx-gauge.scad, tune-button-mx-gauge.stl, tune-button-printed.scad, tune-button-xiao-lid.stl]
2026-11-05 Printed cases: lid goes over soldered switches (16.0 mm holes)
    The first printed lid wouldn't close because the switches were already
    soldered to the board, and a 14.1 mm MX clip hole can't pass the
    switch's widest part, its 15.6 mm top housing: the plate rode up the
    housings and stood 3 mm proud.
    mx_fit = "over" (now the default) makes the holes 16.0 mm, so the lid
    goes down over soldered switches; the posts already clamp the board, so
    the plate needn't hold the switches. mx_fit = "clip" keeps 14.1 mm for
    clipping switches in before soldering. The gauge follows the choice
    (15.8-16.4 mm, or 14.0-14.3). Assembly steps rewritten for the new order.
    [tune-button-c3-lid.stl, tune-button-mx-gauge.scad, tune-button-mx-gauge.stl, tune-button-printed.scad, tune-button-xiao-lid.stl]
2026-11-05 Printed cases: 16.6 mm over-fit holes, and make the hole size actually apply
    The switches measure 16.3 mm at their widest, not the 15.6 spec. And the
    16.0 mm lids weren't: stack.scad sets mx_hole first, and OpenSCAD evaluates
    a reassigned variable at its first assignment, before mx_fit exists, so the
    lids still had 14.1 mm holes. The printed case now uses pmx_hole. Gauge
    moves to 16.4-17.0.
    [tune-button-c3-lid.stl, tune-button-mx-gauge.scad, tune-button-mx-gauge.stl, tune-button-printed.scad, tune-button-xiao-lid.stl]
2026-11-05 Printed cases: 16.8 mm over-fit holes, from the gauge print
    The switches drop through the gauge's 16.8 mm hole easily.
    [tune-button-c3-lid.stl, tune-button-printed.scad, tune-button-xiao-lid.stl]
2026-11-05 xiao rev B: XIAO turned to the left edge, spring pins to its BAT pads, reversible switches
    On rev A the XIAO's antenna lead and the wires to its BAT pads crossed the
    switches. The XIAO now faces its USB-C out of the left edge; two YTC1P-8535
    spring pins (J4 VBAT, J5 GND) press on its BAT pads in place of the wired
    header, staggered along the pads since their 2 mm flanges can't sit 1.9 mm
    apart; the battery JST moves to the right edge. The switch footprint
    (lib/tune-button.pretty) carries both pin pairs, so each switch can go on
    either side. Rerouted (clean on the first attempt) and frozen; ERC, DRC with
    parity and jlc_verify clean. c3 and c3-jst rebuild identical (canon).
    Not yet audited; th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
    [tune-button-xiao.kicad_pcb, tune-button-xiao.kicad_sch]
2026-11-05 xiao rev B, audit round 1: one pogo pin, K3 off SW1's back pin, switch rules for our own MX footprint
    - SF2: drop J5 (the XIAO's BAT- is its GND, which J2 pin 2 carries); J4 centred
    on the BAT+ pad, with JLC's 2.3 mm pad. The two staggered pins had left VBAT
    and GND metal 0.2 mm apart, 12 mm tall.
    - SF1: K3 re-laid at x=12.5, 0.44 mm from SW1's back-pair pin 1 (was 0.259).
    The class: the toolkit knew a key switch only by KiCad's library name, so our
    reversible footprint was checked on one layer. vendor/ gets edgecoil-pcb
    9baf226's is_key_switch() by hand on 798a589 (re-vendoring all of upstream
    changes the c3 boards' copper).
    - LED run moved 0.445 mm off J1.7; back text below the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
    [tune-button-xiao.kicad_pcb, tune-button-xiao.kicad_sch]
2026-11-05 xiao rev B, audit round 2: J5's stub dropped, stitching restored under the back text, docs say one pin
    - the GND stub left on J5's via is gone
    - six stitching vias at y=61.45 replace the six the back text displaced
    - the two re-laid K3 joints snap exactly onto the existing segment ends
    - README and gen.py no longer describe two spring pins
    J1's hidden label accepted (no clear spot). ERC/DRC clean, c3 and c3-jst
    canon-identical, crowded_pins [], jlc_verify ok.
    [tune-button-xiao.kicad_pcb]
2026-11-05 xiao rev B, audit round 3: the unplug note's reason was wrong (no GND pin is next to J4)
2026-11-05 xiao rev B, audit round 4: D0's strapping-pin risk, the LED with back-mounted switches, header wording
    README only. D0 (GPIO2) carries the battery divider, so with a cell it sits
    mid-rail on a strapping pin Espressif recommends pulling up; untested, so the
    README says to check USB flashing with a cell connected (rev A has the same
    divider). With the switches on the back the LED faces into the case. Two
    places still named rev A's header as the XIAO board's part.
2026-11-05 xiao rev B, audit round 5: README says the render is rev A, the XIAO's header pins, the wake stub exists, the two-pin arithmetic
2026-11-05 xiao rev B, audit round 6: the panel carries rev B; README on the antenna, the wake stub, JLC's panel note, firmware status
    - SF1: the committed panel still held rev A's XIAO board; rebuilt (panel.py's
    checks pass, 79 parts in 31 lines)
    - the antenna: the XIAO's far end now faces the free top right; mount the FPC
    in the case, off the pour
    - the wake stub reads D4 within about a millisecond (as the firmware says)
    - JLC's current panel note (5 mm edges, 2 mm tooling holes, fiducials 3.85 mm)
    - the firmware section said neither build had run on a board
    [tune-button-panel.kicad_pcb]
2026-11-05 xiao rev B, audit round 7: bring-up status everywhere, BAT+ pad's real size, JLC's tab width, the U.FL is on the front
    - status: rev A arrived; the C3 board's keys, sleep and wake work; the XIAO
    board is flashed; c3-jst and app pairing untested (both READMEs and
    platformio.ini still said not built)
    - Seeed's back photo shows BAT+ at about 1.9 x 0.9 mm, not the footprint's
    2.5 x 1.1: J4's tip has ~+/-0.45 mm along the row; check it stands upright
    and mark its tip on arrival
    - JLC now wants mouse-bite tabs at least 5 mm wide (the panel's are 2.3-3.0)
    - wiring.md: the U.FL socket is on the XIAO's front, not its back
2026-11-05 xiao rev B, audit round 8: the panel rebuilds identically every time; the with-cell flash check is still open
    - panel.py snaps zone outlines to 1 um before filling: gen.py's item order
    varies between runs and KiKit's merge left a vertex at 1.999999 or 2.0
    (canon failed on about half of all rebuilds). Four fresh rebuilds now
    compare identical; the committed panel is the snapped one (rule-area
    outlines moved by under 1 um).
    - README: the XIAO was flashed without a cell; checking a flash with one (D0
    strap) is still to do and is now listed under When the boards arrive; the
    top right isn't empty (J3, the LED); 15.24 mm is Seeed's own footprint.
    [tune-button-panel.kicad_pcb]
2026-11-05 xiao rev B, audit round 9: snap the panel's board outline too; panel fab files in UTC; one story for the D0 check
    - the zone snap left c3's antenna-notch edge drifting a few nm in about 1 of
    7 rebuilds; Edge.Cuts segments and arcs are now snapped too (16 of 16
    fresh rebuilds then compared equal). My round 8 'every time' rested on four
    samples.
    - panel.py's export sets TZ=UTC, as build.sh does
    - D0: rev B moves the divider before ordering if the with-cell flash fails
    (the pin map said 'a later revision'); 'without a cell' wherever the XIAO's
    flash is mentioned; design.md bench test 1 names the cell and says c3's
    pass doesn't cover the XIAO (GPIO2 pulled up there)
    - the top right a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
    [tune-button-panel.kicad_pcb]
2026-11-05 xiao rev B, audit round 10: panel zip entries in UTC, Mounting holds its own notes, one story for GPIO2 in wiring.md
    - time.tzset() after TZ=UTC: Python stamped the zip's entries in local time
    - the rev B section moves below the c3 and c3-jst mounting notes it had
    split from their heading
    - wiring.md and the pcb README give the same range (1.5-2.1 V for a
    3.0-4.2 V cell) and both ask for the with-cell flash check
2026-11-05 xiao rev B, audit round 12: every prose line in the pcb README within 100 characters
    Round 11's rewrap had pushed the overflow onto the next line. Ten blocks
    rewrapped by script; the text with whitespace collapsed is identical, and
    every list item, heading and table row starts as before.
2026-11-05 Printed lids: the screw counterbores open out through the corners
    About 0.5 mm of wall stood between each counterbore and the lid's outer
    corner, less than the 0.6 mm bed chamfer: the slicer (Bambu's thin-region
    rule) dropped it on the first layer and flagged the second as floating, and
    a printed one chipped. Checked by slicing every 0.2 mm with the slicer's
    rule (keep what survives offset -w/2, +w): the old xiao lid floats at two
    corners, the new c3 and xiao lids nowhere. The hood's screws are in bosses
    and unchanged.
    [tune-button-c3-lid.stl, tune-button-printed.scad, tune-button-xiao-lid.stl]
2026-11-09 Printed c3 with a big button: a 22 mm panel-mount button beside the keys
    big_button = true (variant c3): the case grows left into a tower whose roof takes the button
    (28.5 mm nut, 30 mm head, 26 mm deep, measured), with a 502535 cell on the floor under it. The
    board drops 6.4 mm, so the key side is 14.6 mm tall, stepping up to 31 mm at the tower. Five M3
    screws; the tower's riser clamps the lid's left edge. TP1's header is not fitted on this variant.
    check-stack.py checks it as c3-btn (printed only), takes the button and cell from the case's own
    echo, and runs one variant with CHECK_ONLY. It also gains the rev B pogo pin's height, which it
    had lacked since the xiao board went to rev B.
    [tune-button-c3-btn-base.stl, tune-button-c3-btn-lid.stl, tune-button-c3-btn-tower.stl, tune-button-printed.scad]
2026-11-09 Printed c3 big-button case: its preview image
2026-11-09 Printed c3 big-button case: print finishing
    The riser's bed-edge chamfer ran only 13 mm of the 82 (extruded the wrong way in y); it now runs
    the full length. 1 mm 45-degree fillets inside the tower where roof meets walls and riser (the
    most the 28.5 mm nut leaves room for). A 0.2 mm gap where the lid's left end meets the tower,
    its bed edge chamfered for elephant foot, and a V-groove down the joint on each outer face.
    Checked: overhangs are only the 45-degree bed chamfers and the screw seats' one-layer bridges;
    slicer thin-region check clean on all three parts; check-stack c3-btn clean.
    [tune-button-c3-btn-base.stl, tune-button-c3-btn-lid.stl, tune-button-c3-btn-tower.stl, tune-button-printed.scad]
2026-11-09 Printed c3 big-button case: lid over the cell, button centred on the tower
    The tower now covers only the button's corner. The lid runs on over the 502535 cell, flush with
    the top over the keys, so the case is 14.6 mm tall everywhere but the tower. The tower's back
    inner face sits just past the cell's fence (step_y = 30.3), and its riser stands on the lid along
    both inner edges, with bed chamfers and V-grooves at the two outside joints.
    The button is centred front to back on the tower's top (y 45.5 -> 52.0), its nut 4 mm from the
    front wall. Six M3 screws: TL, TM and BR in the lid; BL, BM and LM (left wall, just inside the
    tower's back, 5.6 mm clear of the nut) in the tower.
    check-stack.py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
    [tune-button-c3-btn-base.stl, tune-button-c3-btn-lid.stl, tune-button-c3-btn-tower.stl, tune-button-printed.scad]
2026-11-09 Printed c3 big-button case: a fourth tower screw, in its inner back corner
    RM sits in the tower's inner back corner, its boss tangent to both riser faces and filling the
    corner so it joins them (0.2 mm clear of the lid's cut edges below). With the button centred
    forward there is room: 17 mm from the button's centre circle to the boss. In the base its boss
    stands 0.1 mm off the cell's fence, so a web joins them, outside the cell's pocket. The cell does
    not move: TL's boss stops it going back, and turned it would run under the tower.
    Seven M3 screws: lid TL, TM, BR; tower LM, BL, BM, RM.
    Checked: check-stack c3-btn clean (52 parts, clamp); slicer check 0 floating on the base. The
    tower flags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
    [tune-button-c3-btn-base.stl, tune-button-c3-btn-lid.stl, tune-button-c3-btn-tower.stl, tune-button-printed.scad]
2026-11-13 case: raven variant of the big-button case
    raven = true (with big_button) gives the tower an organic raven's head:
    the footprint blends up into a rounded crown, the 22 mm button is the
    eye with a ring groove, and a keel-section bill runs off the front-right
    corner, clear of the keycaps' travel by 1.5 mm. The head has no holes on
    top: its four screws come up from under the base into heat-set inserts
    at the foot of full-height columns. Every down-facing face is 45 deg or
    steeper for printing roof-down. The lid is the big button's.
    check-stack.py checks c3-raven; build-stack.sh builds its base and tower.
    [tune-button-c3-raven-base.stl, tune-button-c3-raven-tower.stl, tune-button-printed.scad]
